irsad-najib/capstone/3d-new/preview/adj_detail.png

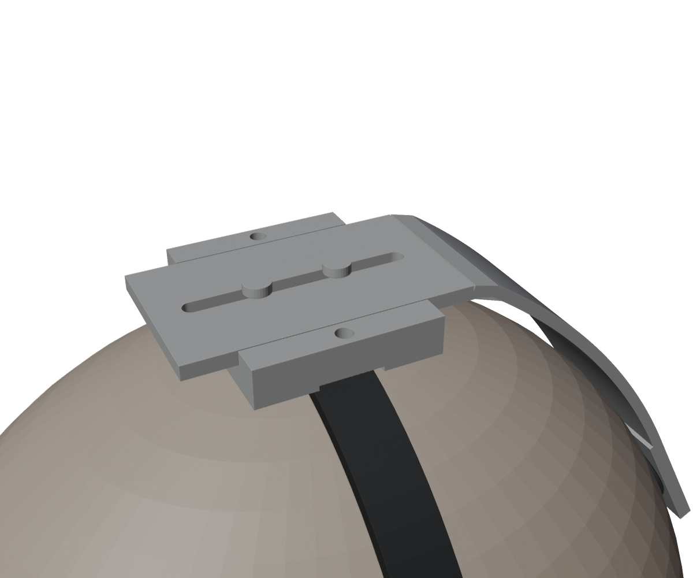
3d-new/preview/adj_detail.png
