irsad-najib/capstone/3d-new/preview/adj_persp.png

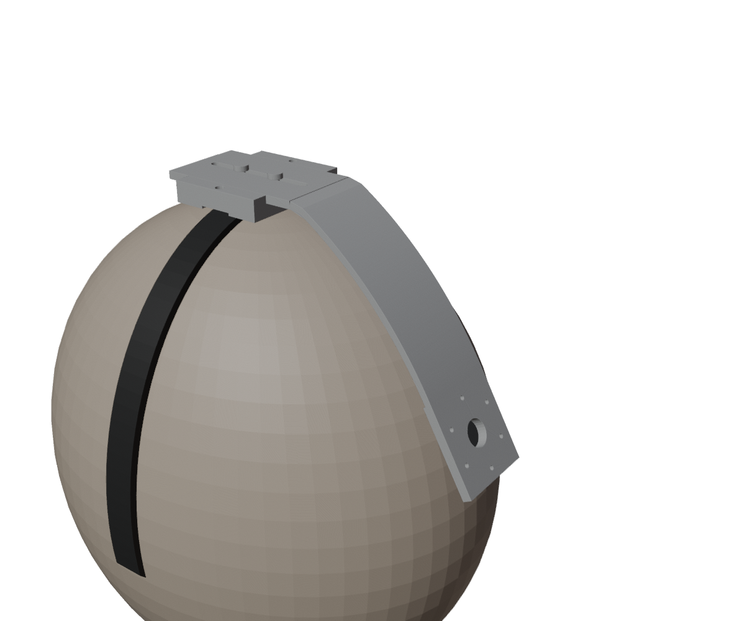
3d-new/preview/adj_persp.png
