irsad-najib/capstone/3d-new/preview/adj_side.png

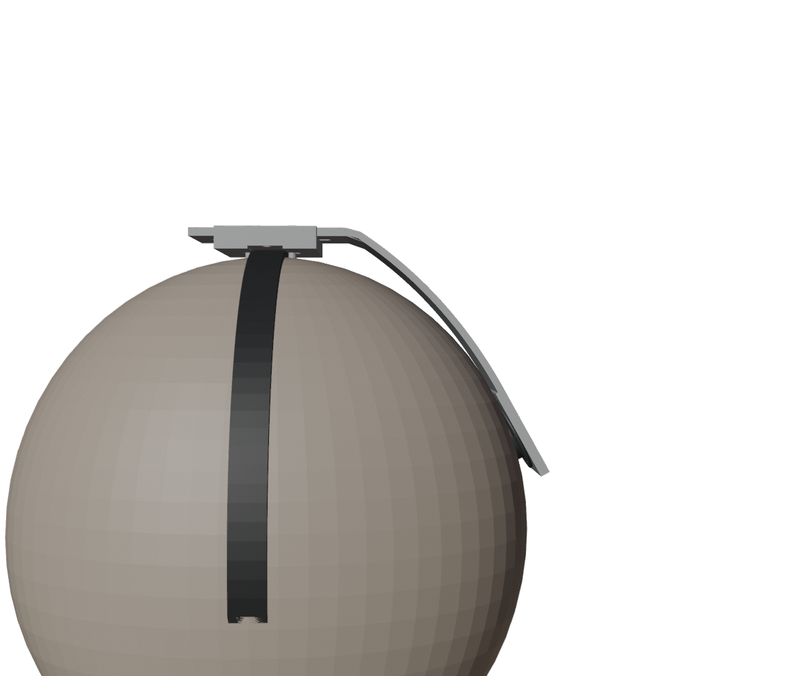
3d-new/preview/adj_side.png
