irsad-najib/capstone/3d-new/preview/arm_persp.png

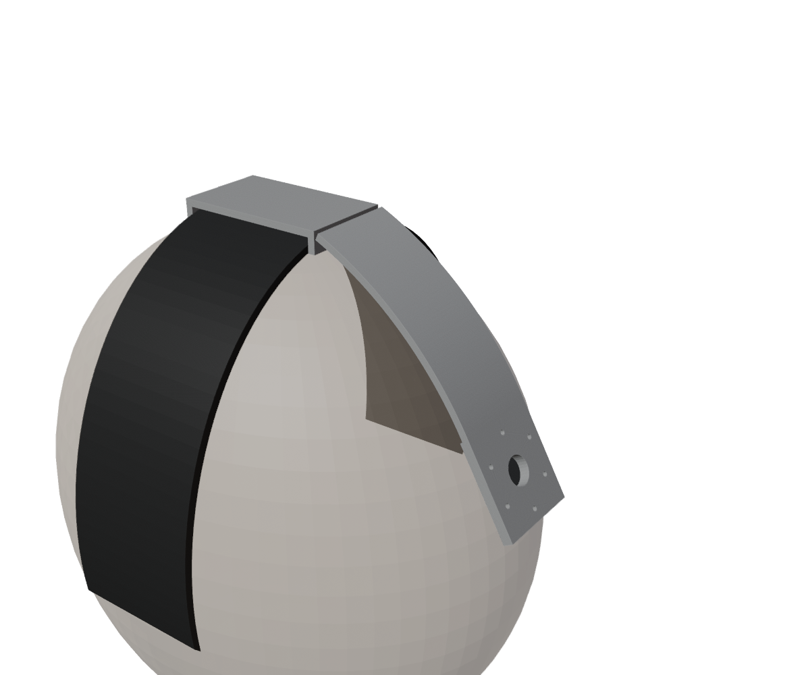
3d-new/preview/arm_persp.png
