irsad-najib/capstone/3d-new/preview/arm_side.png

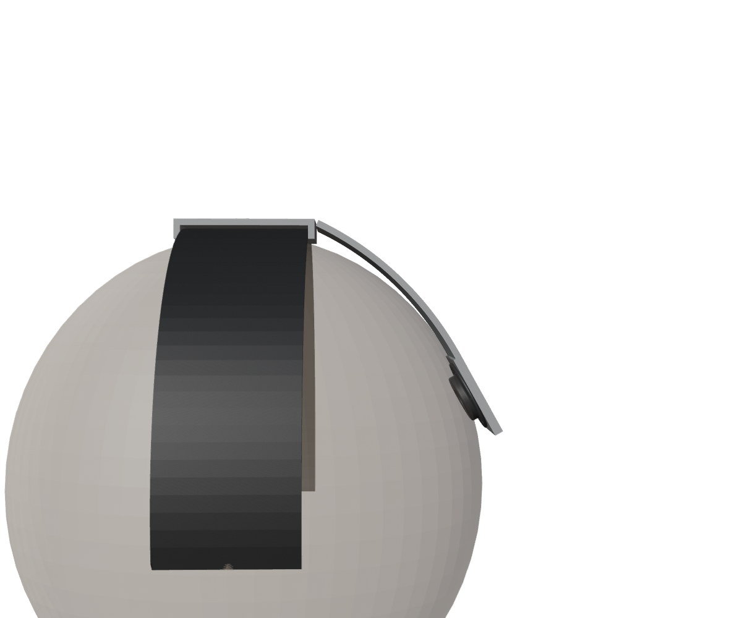
3d-new/preview/arm_side.png
