irsad-najib/capstone/capstone-3d/docs/preview_front_textured.png

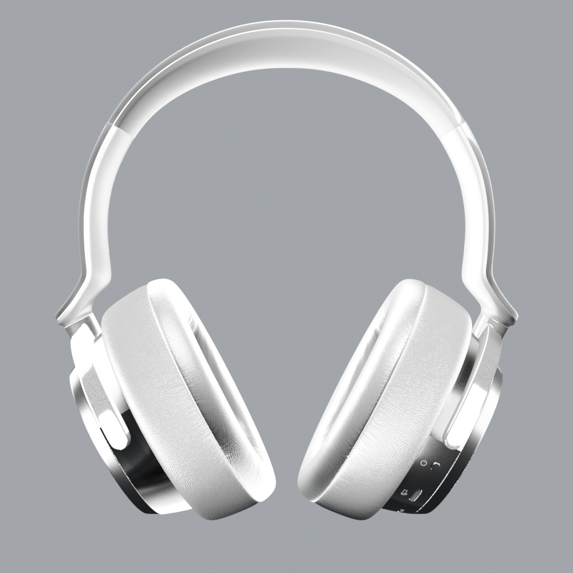
capstone-3d/docs/preview_front_textured.png
