irsad-najib/capstone/capstone-3d/docs/preview_hero.png

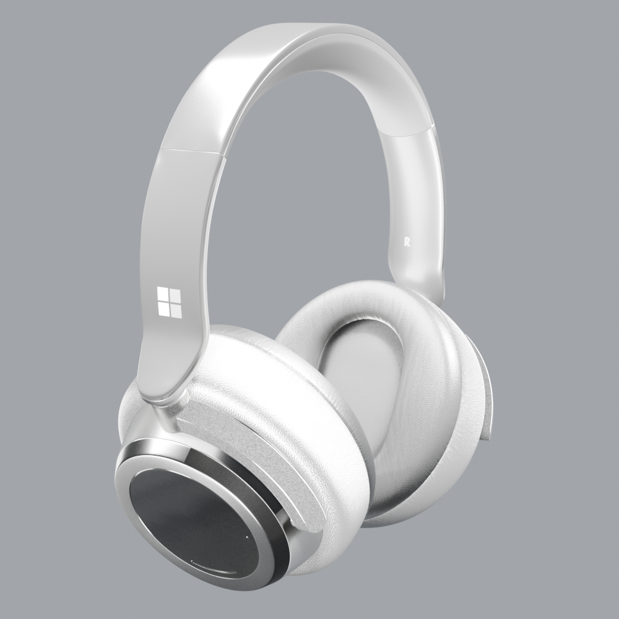
capstone-3d/docs/preview_hero.png
