irsad-najib/capstone/capstone-3d/docs/redesign_front.png

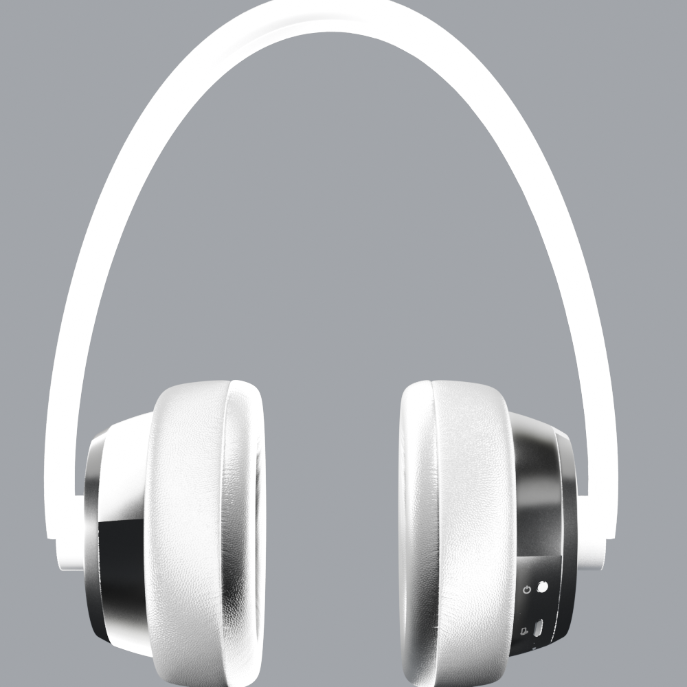
capstone-3d/docs/redesign_front.png
