irsad-najib/capstone/capstone-3d/docs/redesign_hero.png

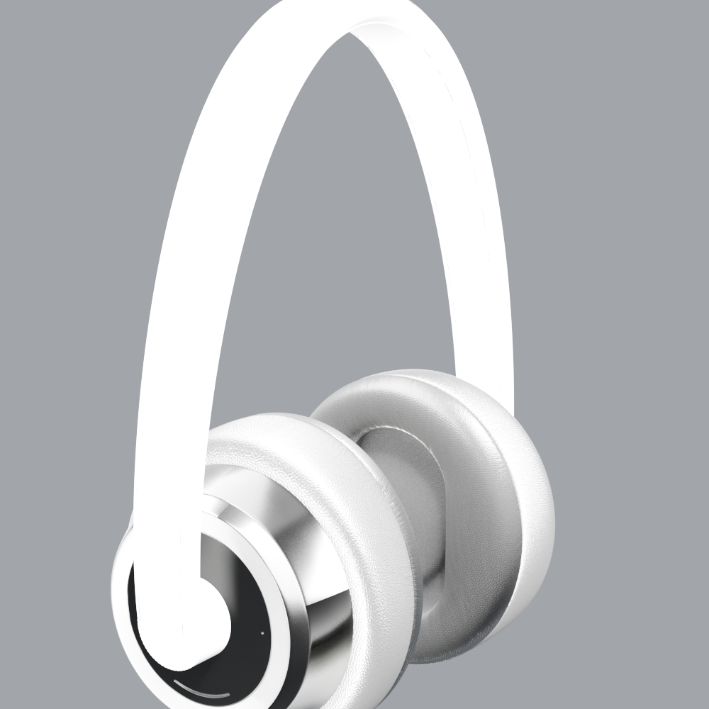
capstone-3d/docs/redesign_hero.png
