irsad-najib/capstone/capstone-3d/docs/v2_front.png

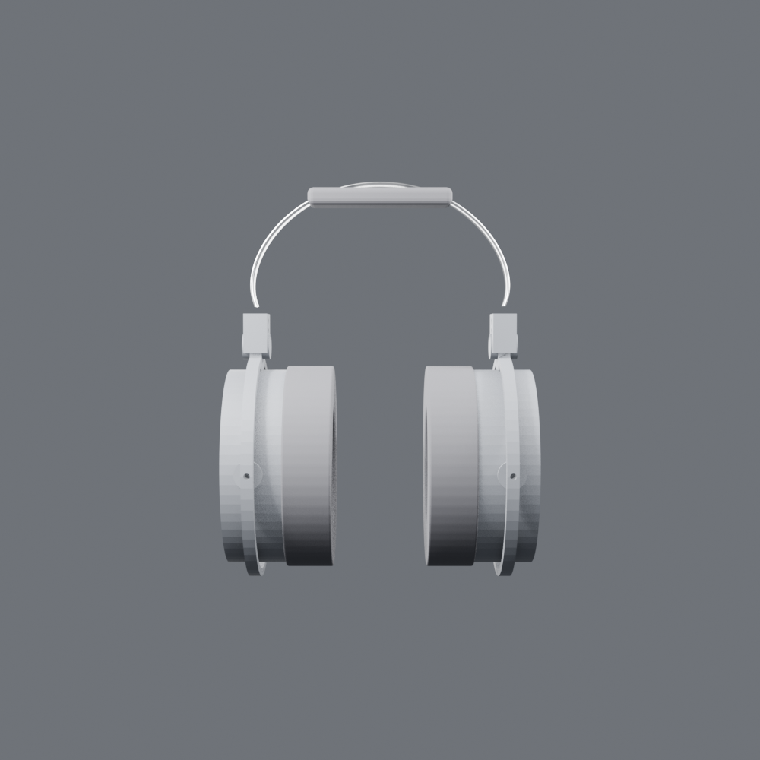
capstone-3d/docs/v2_front.png
