irsad-najib/capstone/capstone-3d/docs/v2_hero.png

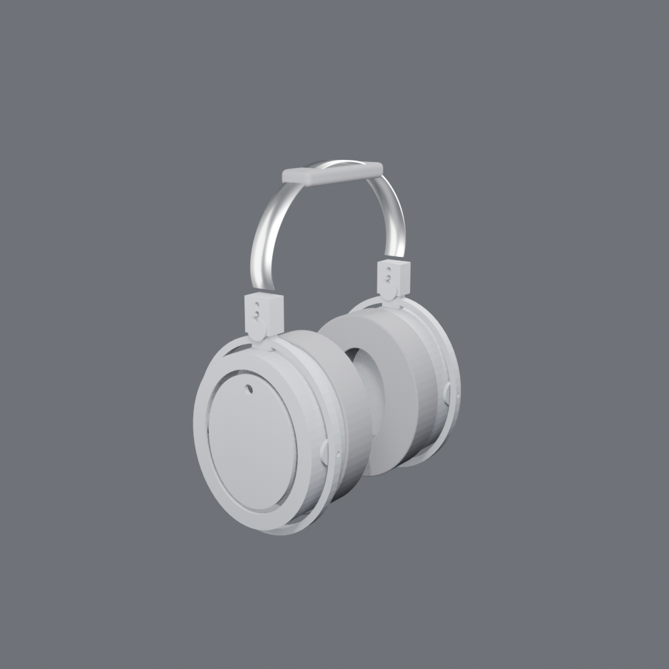
capstone-3d/docs/v2_hero.png
