irsad-najib/capstone/capstone-3d/docs/v2_side.png

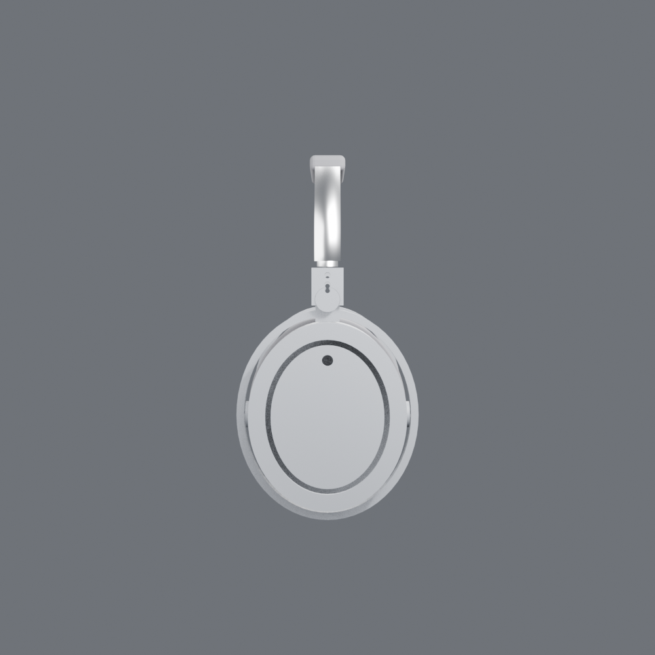
capstone-3d/docs/v2_side.png
