irsad-najib/capstone/frontend/stitch_neuropulse_abr_screening_system/neurosound_live_scan_mobile/screen.png

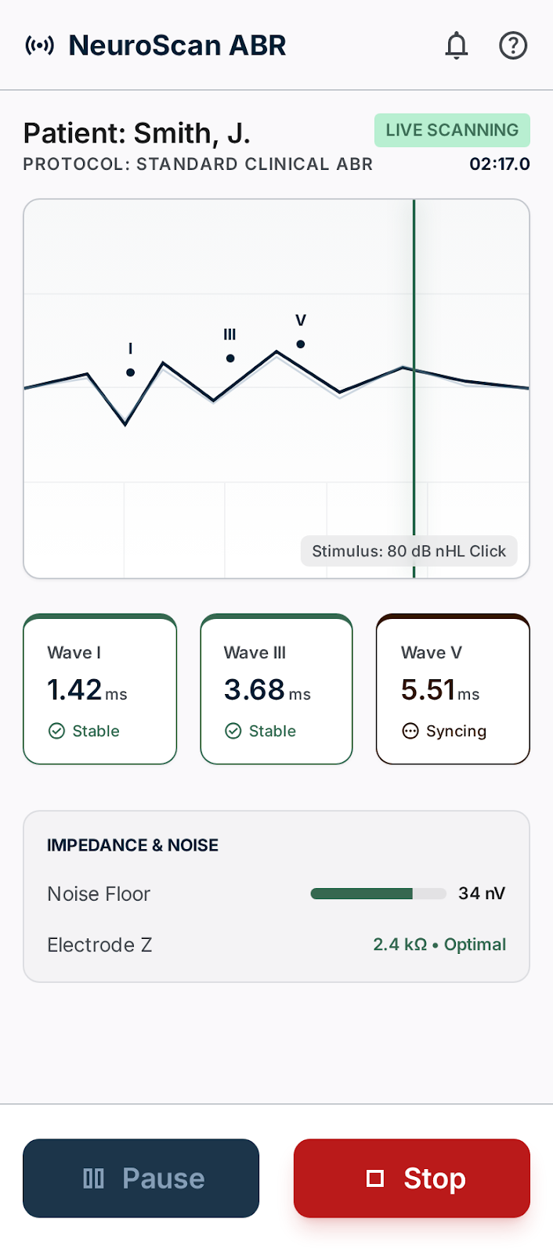
frontend/stitch_neuropulse_abr_screening_system/neurosound_live_scan_mobile/screen.png
