irsad-najib/capstone/3d-new/arsip/export_lama/Corong_Pelat_PETG.stl

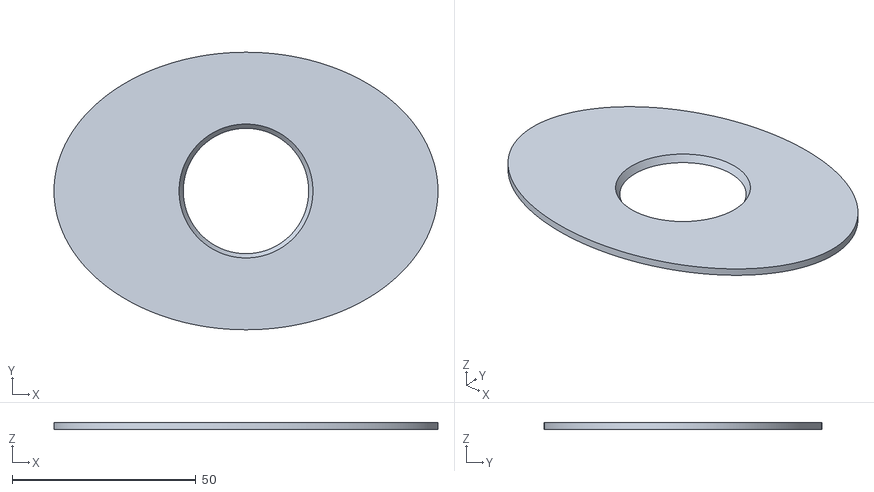
[picture p19: CAD file, 2026-10-26]
3d-new/arsip/export_lama/Corong_Pelat_PETG.stl
104.6 x 75.6 x 2.00
