irsad-najib/capstone/3d-new/BAMBU PROJECT/Dudukan_Driver.3mf

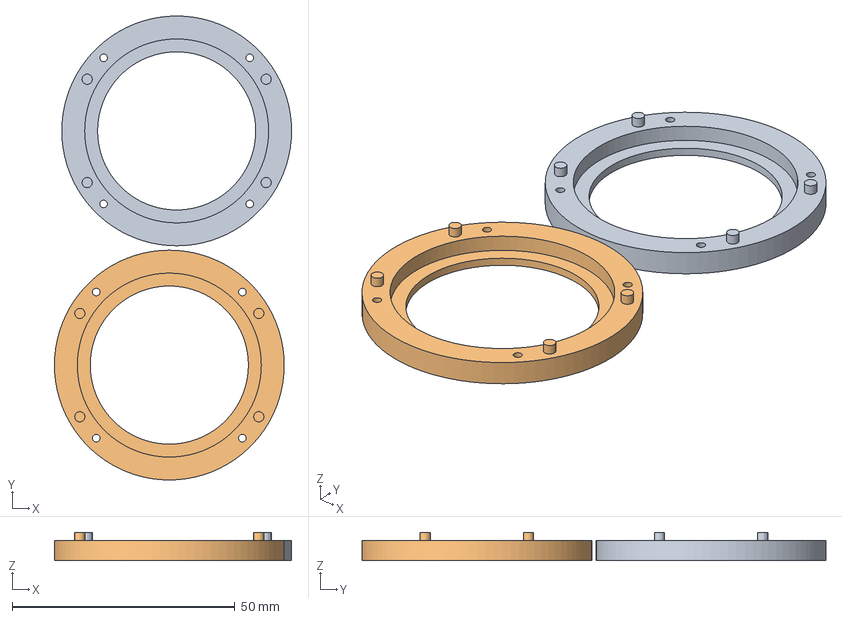
[picture p20: CAD file, 2026-10-26]
3d-new/BAMBU PROJECT/Dudukan_Driver.3mf
53.3 x 104.2 x 6.30 mm
Dudukan_Driver.stl x 2
