irsad-najib/capstone/3d-new/export/Corong_TPU.stl

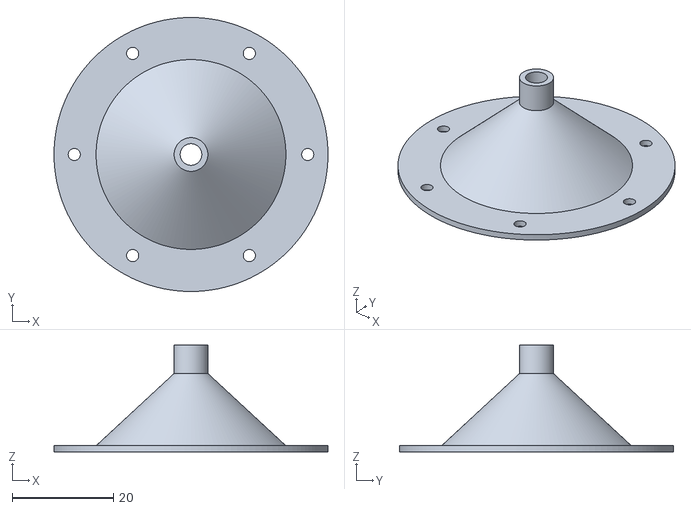
[picture p21: CAD file, 2026-10-26]
3d-new/export/Corong_TPU.stl
54.0 x 54.0 x 21.0
