irsad-najib/capstone/3d-new/export/uji_toleransi/Uji_Dudukan.stl

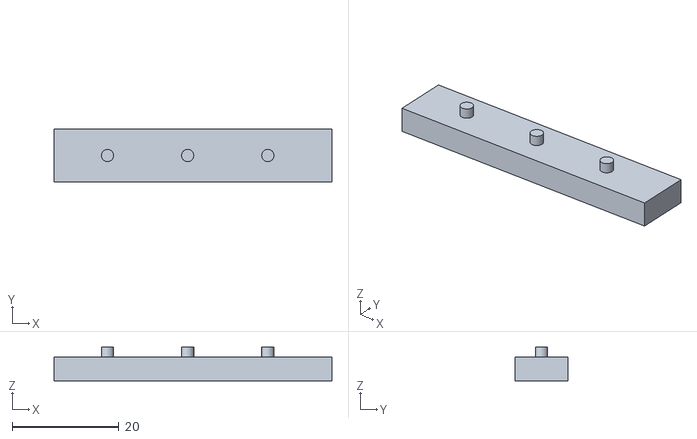
[picture p22: CAD file, 2026-10-26]
3d-new/export/uji_toleransi/Uji_Dudukan.stl
52.0 x 10.0 x 6.30
