irsad-najib/capstone/3d-new/arsip/export_lama/Kubah_Oval.stl

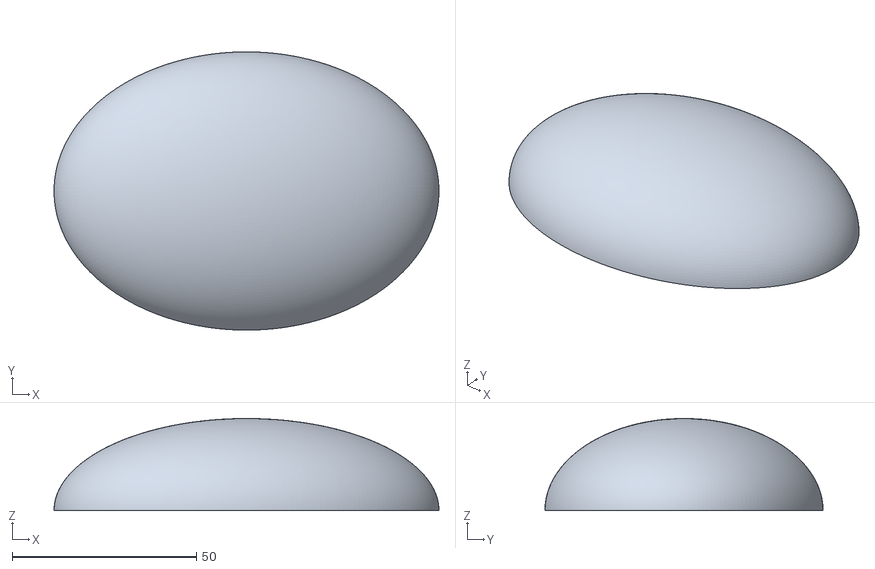
[picture p23: CAD file, 2026-10-26]
3d-new/arsip/export_lama/Kubah_Oval.stl
104.6 x 75.6 x 25.0
