irsad-najib/capstone/3d-new/BAMBU PROJECT/Uji_TPU.3mf

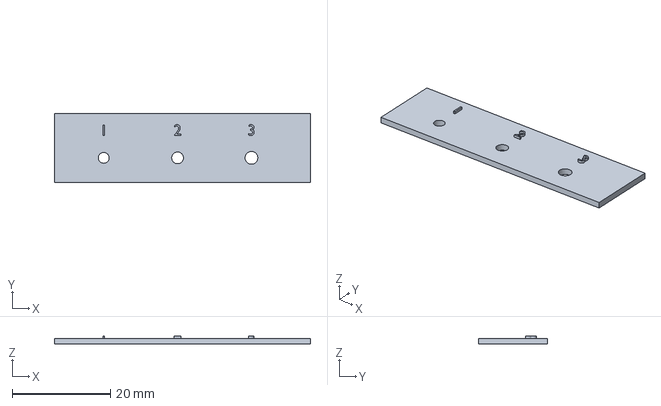
[picture p24: CAD file, 2026-10-26]
3d-new/BAMBU PROJECT/Uji_TPU.3mf
52.0 x 14.0 x 1.70 mm
