irsad-najib/capstone/3d-new/export/Kubah.stl

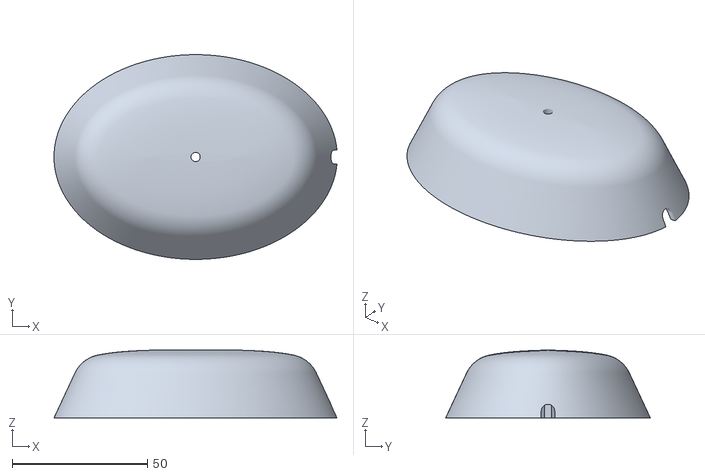
[picture p25: CAD file, 2026-10-26]
3d-new/export/Kubah.stl
104.5 x 75.6 x 25.0
