irsad-najib/capstone/3d-new/arsip/export_lama/Corong_Kerucut_TPU.stl

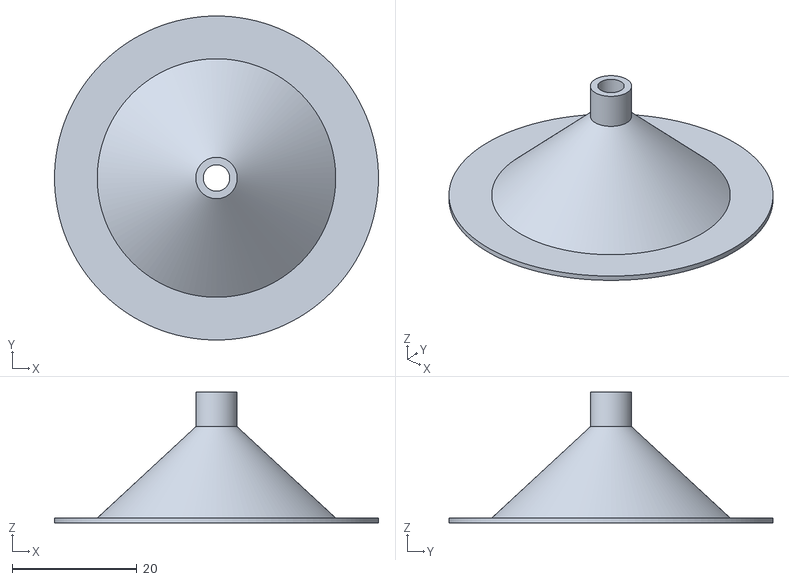
[picture p26: CAD file, 2026-10-26]
3d-new/arsip/export_lama/Corong_Kerucut_TPU.stl
52.0 x 52.0 x 21.0
