irsad-najib/capstone/3d-new/BAMBU PROJECT/corong.3mf

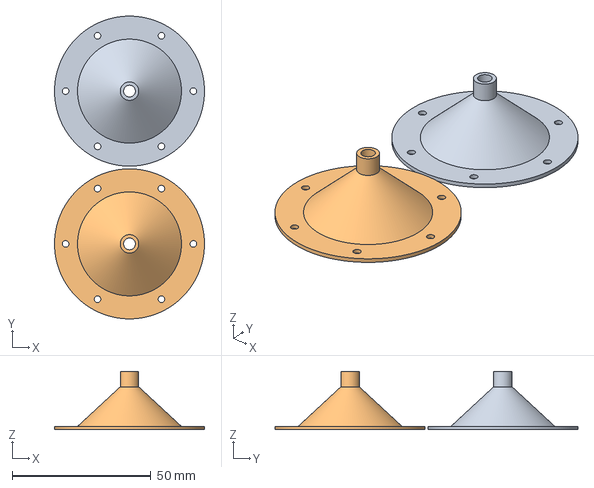
[picture p27: CAD file, 2026-10-26]
3d-new/BAMBU PROJECT/corong.3mf
54.0 x 109.0 x 21.0 mm
Corong_TPU.stl x 2
