irsad-najib/capstone/3d-new/export/Pelat_PETG.stl

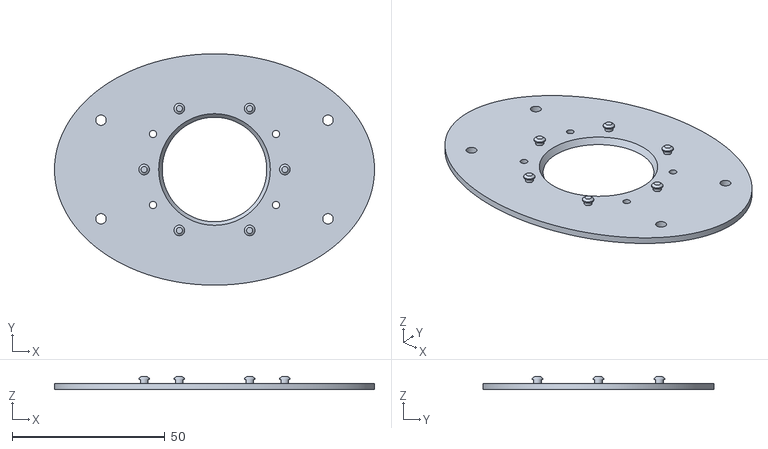
[picture p28: CAD file, 2026-10-26]
3d-new/export/Pelat_PETG.stl
104.6 x 75.6 x 4.20
