irsad-najib/capstone/3d-new/export/uji_toleransi/Uji_Tiang.stl

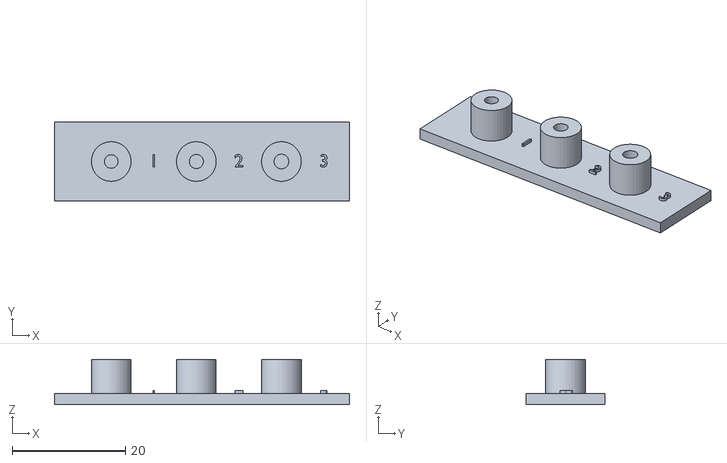
[picture p29: CAD file, 2026-10-26]
3d-new/export/uji_toleransi/Uji_Tiang.stl
52.0 x 14.0 x 8.00
