irsad-najib/capstone/3d-new/BAMBU PROJECT/Pelat_PETG.3mf

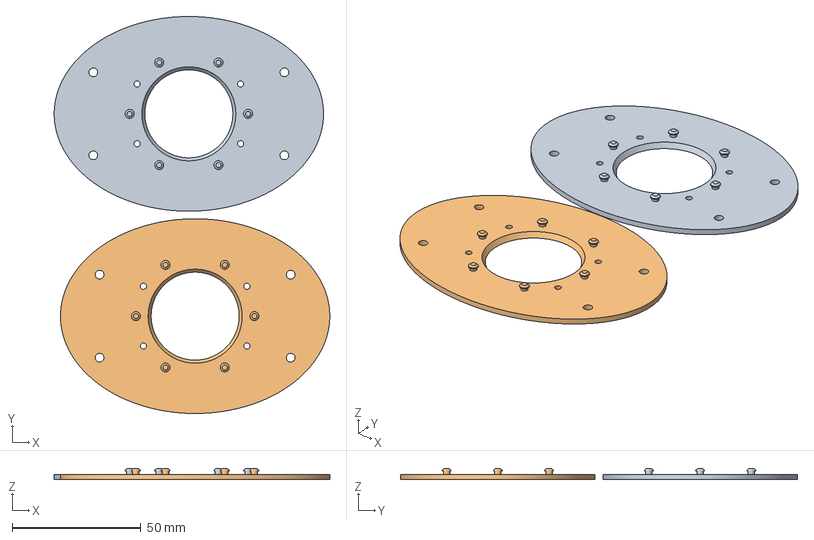
[picture p30: CAD file, 2026-10-26]
3d-new/BAMBU PROJECT/Pelat_PETG.3mf
107.0 x 154.2 x 4.20 mm
Pelat_PETG.stl x 2
