irsad-najib/capstone/3d-new/export/Dudukan_Driver.stl

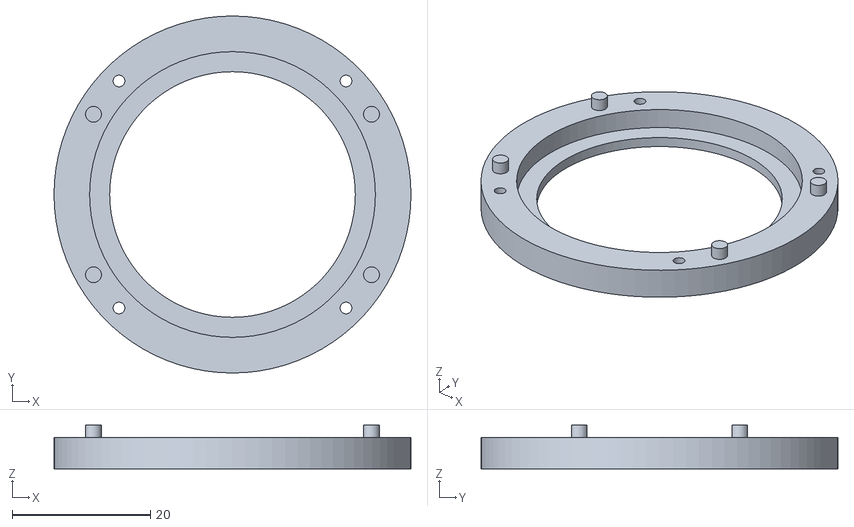
[picture p31: CAD file, 2026-10-26]
3d-new/export/Dudukan_Driver.stl
51.6 x 51.6 x 6.30
