irsad-najib/capstone/3d-new/export/uji_toleransi/Uji_Pelat.stl

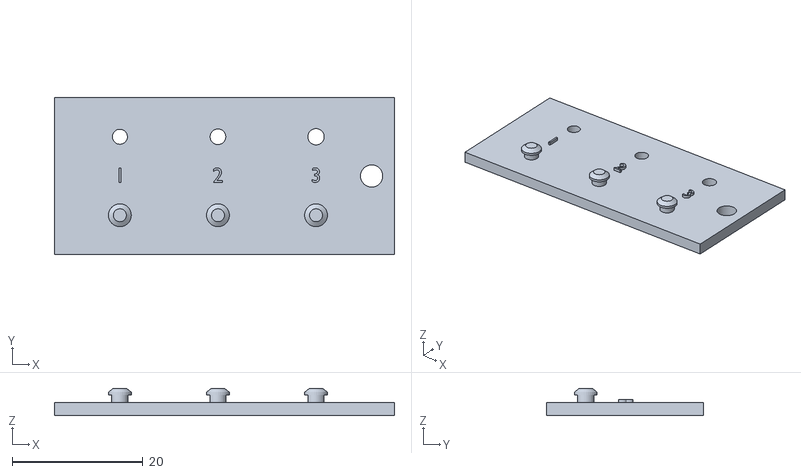
[picture p32: CAD file, 2026-10-26]
3d-new/export/uji_toleransi/Uji_Pelat.stl
52.0 x 24.0 x 4.20
