irsad-najib/capstone/3d-new/BAMBU PROJECT/Uji_PETG.3mf

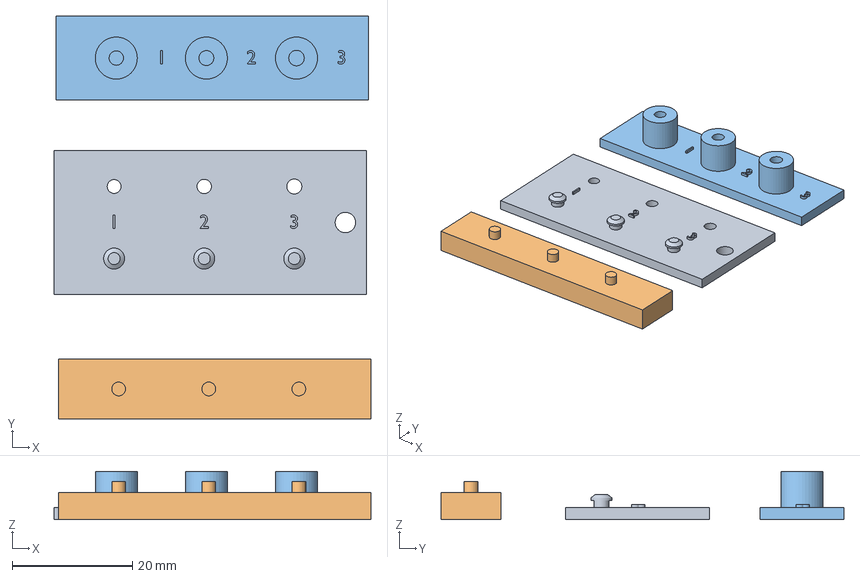
[picture p33: CAD file, 2026-10-26]
3d-new/BAMBU PROJECT/Uji_PETG.3mf
52.8 x 67.1 x 8.00 mm
Uji_Pelat.stl
Uji_Dudukan.stl
Uji_Tiang.stl
