irsad-najib/capstone/3d-new/BAMBU PROJECT/Kubah.3mf

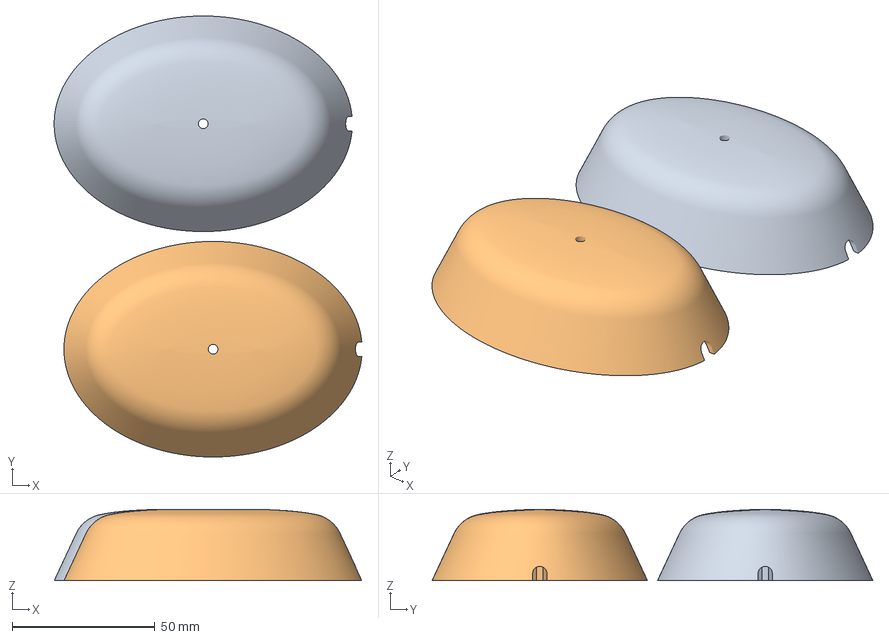
[picture p34: CAD file, 2026-10-26]
3d-new/BAMBU PROJECT/Kubah.3mf
107.9 x 154.7 x 25.0 mm
Kubah.stl x 2
