irsad-najib/capstone/(list of files, cad)

Other CAD files:
3d-new/export/uji_toleransi/Uji_TPU.stl
