irsad-najib/capstone/frontend/stitch_neuropulse_abr_screening_system/neurosound_scan_results_desktop/code.html

neurology

Neurosound Clinical Portal

Clinician Profile

Dr. Sarah Miller Neurologist

menu

search

fingerprint Patient ID: 882-941

notifications account_circle

Diagnostic Result

# NORMAL

Response detected bilaterally. ABR waveforms demonstrate clear morphology and latencies within expected clinical ranges for age and gender.

picture_as_pdf Export Report

Visual Analysis Detailed Metrics

### ABR Waveforms

Left Ear (31.1/s)

Right Ear (31.1/s)

zoom_in fullscreen

#### Key Indicators

Wave V Latency

5.64 ms

Threshold

20 dB nHL

#### Clinical Notes

"Tympanometry Type A bilaterally. Infant remained in quiet sleep for the duration of the scan. Signal quality excellent with minimal artifact rejection."

Component | Latency (ms) | Amplitude (µV) | Status
Wave I | 1.62 | 0.24 | Normal
Wave III | 3.78 | 0.38 | Normal
Wave V | 5.64 | 0.52 | Normal

#### Scan Parameters

Stimulus

Click 100μs

Rate

31.1 / sec

Polarity

Rarefaction

Filter

100-3kHz

#### Signal Integrity

Sweep Completion 93.1%

2048 Sweeps, 142 Rejected. SNR 4.2:1 (Ideal)

© 2024 Neurosound Medical Systems. Clinical Diagnostic Support.

Support Compliance Logout
