irsad-najib/capstone/frontend/stitch_neuropulse_abr_screening_system/neurosound_scan_results_mobile/code.html

arrow_back Scan Results

notifications help_outline

Analysis Status

# NORMAL

check_circle Auditary Brainstem Response Stable

SUMMARY DETAILED METRICS

timer Latency

5.2 ms

signal_cellular_alt SNR

12.4 dB

### ABR Waveform Analysis

fullscreen

ABR Waveform

Wave I Wave V

Left Ear (320Hz)

Baseline

Stimulus Level 85 dB nHL

Click Polarity Rarefaction

Averages Count 2,048

#### Neural Synchrony

Wave V Latency 5.62 ms

Wave I-V Interval 3.98 ms

V/I Amplitude Ratio 2.41

#### Environmental Noise

EEG Residual Noise 24 nV

A-weighted Level 12 dB(A)

share EXPORT PDF save SAVE RECORD
