irsad-najib/capstone/frontend/stitch_neuropulse_abr_screening_system/neurosound_scan_history_desktop/code.html

# Neurosound

Clinical Portal

DR

Dr. Sarah Chen

Neuro-Audiologist

menu

## Neurosound

search

notifications account_circle

### History

Manage and review all patient scan data.

download Export

search

842 Normal

312 Abnormal

130 Inconclusive

Patient | Date | Result | Actions
Elena Rodriguez ID: 442-12 | Oct 24, 2024 | Normal | View
Marcus Thorne ID: 291-55 | Oct 23, 2024 | Abnormal | View
Sarah J. Miller ID: 112-88 | Oct 23, 2024 | Inconclusive | View
James Wilson ID: 673-42 | Oct 22, 2024 | Normal | View

Showing 4 of 1,284 results

chevron_left 1 2 3 chevron_right

© 2024 Neurosound Medical Systems. FDA Cleared.

Support Privacy Logout
