irsad-najib/capstone/frontend/stitch_neuropulse_abr_screening_system/neurosound_scan_history_mobile/code.html

NeuroScan ABR

notifications help_outline

# Scan History

search

All Scans Stable Review Needed Archived

person

### Liam Henderson

Stable

Oct 24, 2024 • ID: #4492-B

chevron_right

person

### Sarah Jenkins

Review Required

Oct 23, 2024 • ID: #4491-A

chevron_right

person

### Benjamin Thorne

Stable

Oct 23, 2024 • ID: #4489-C

chevron_right

Clinical Environment

#### Monthly Diagnostics Summary

You have completed 124 scans this month with 98% data accuracy.
