irsad-najib/capstone/frontend/stitch_neuropulse_abr_screening_system/neurosound_scan_history_desktop/screen.png

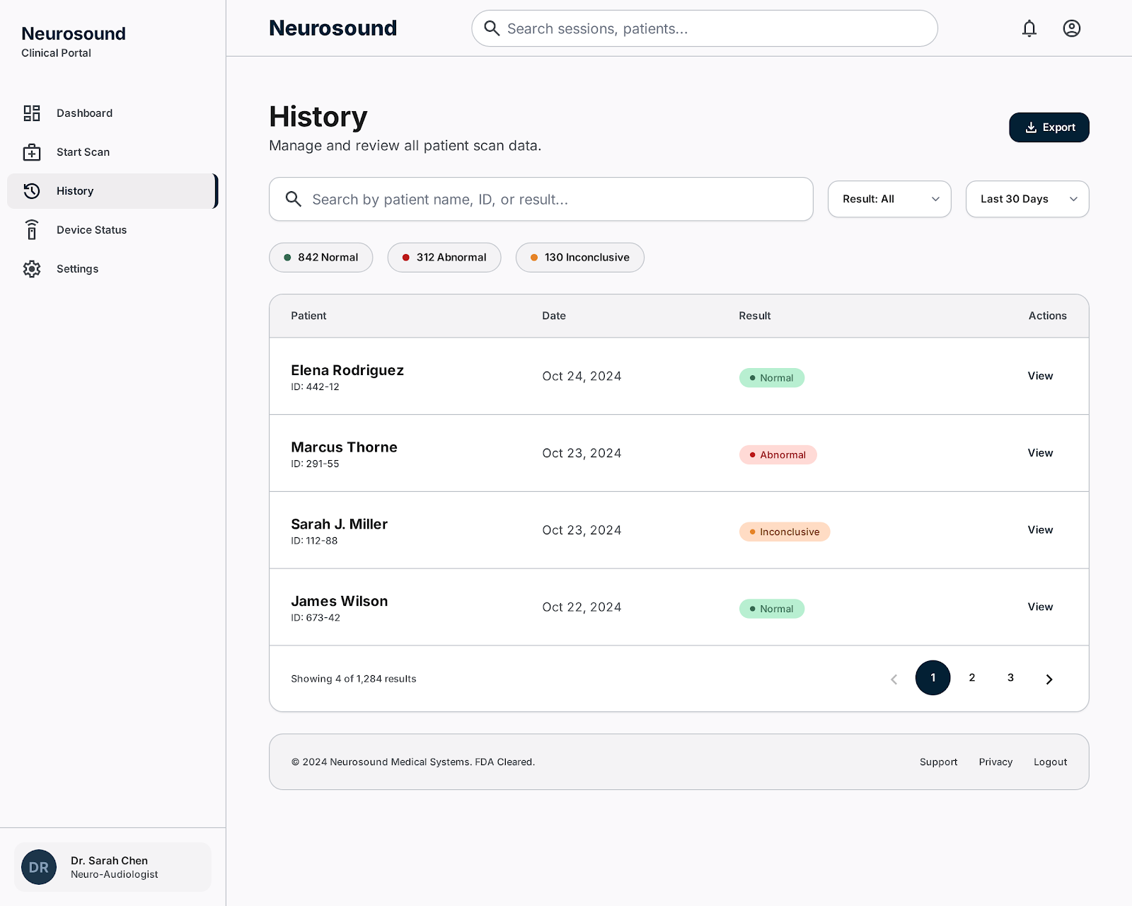
frontend/stitch_neuropulse_abr_screening_system/neurosound_scan_history_desktop/screen.png
