irsad-najib/capstone/schematic-fix/board-1-analog.pdf

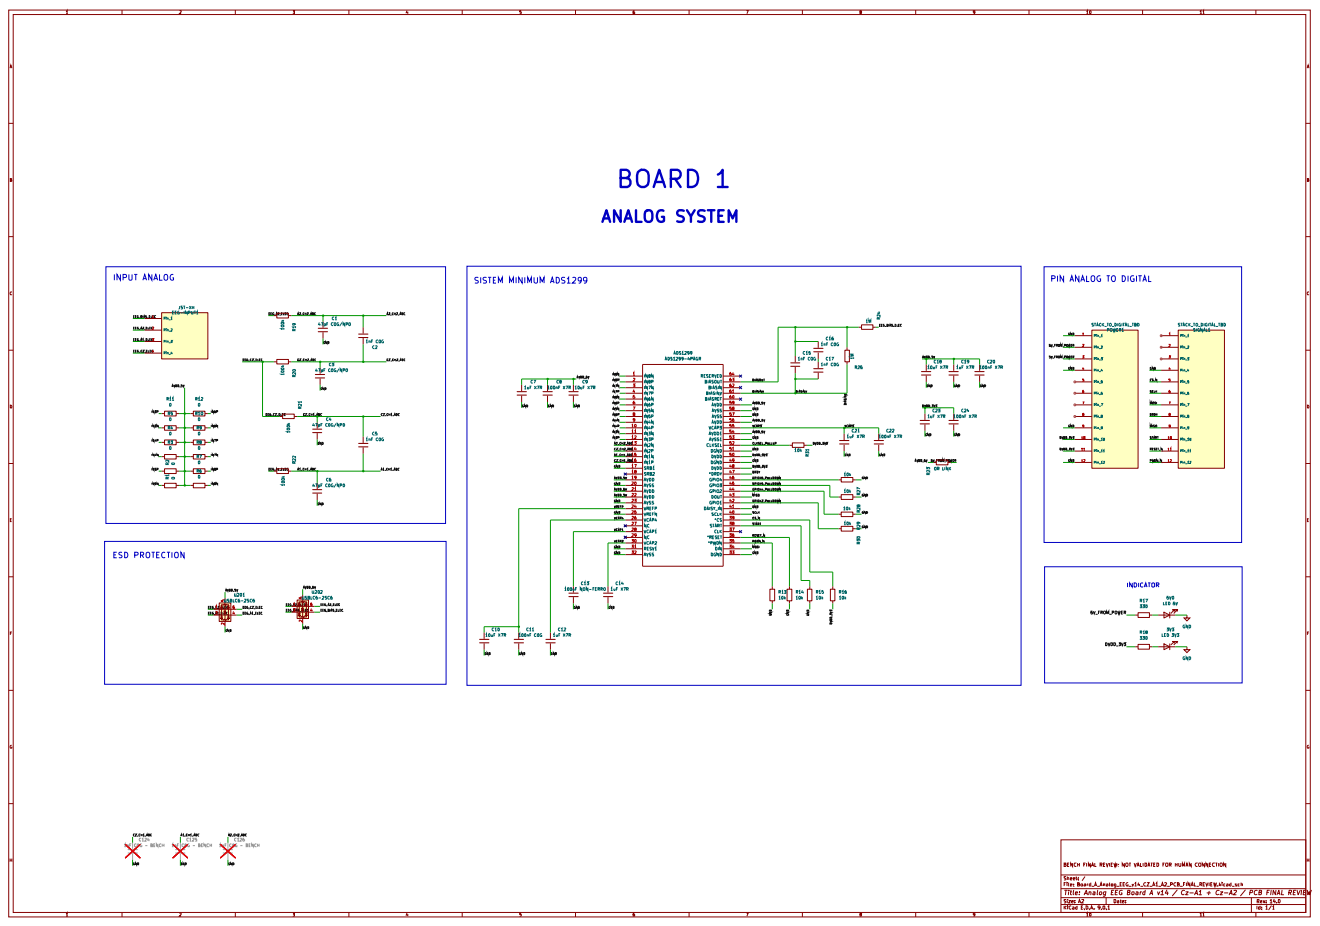
[picture p40: page 1]
