irsad-najib/capstone/schematic-fix/board-2-digital.pdf

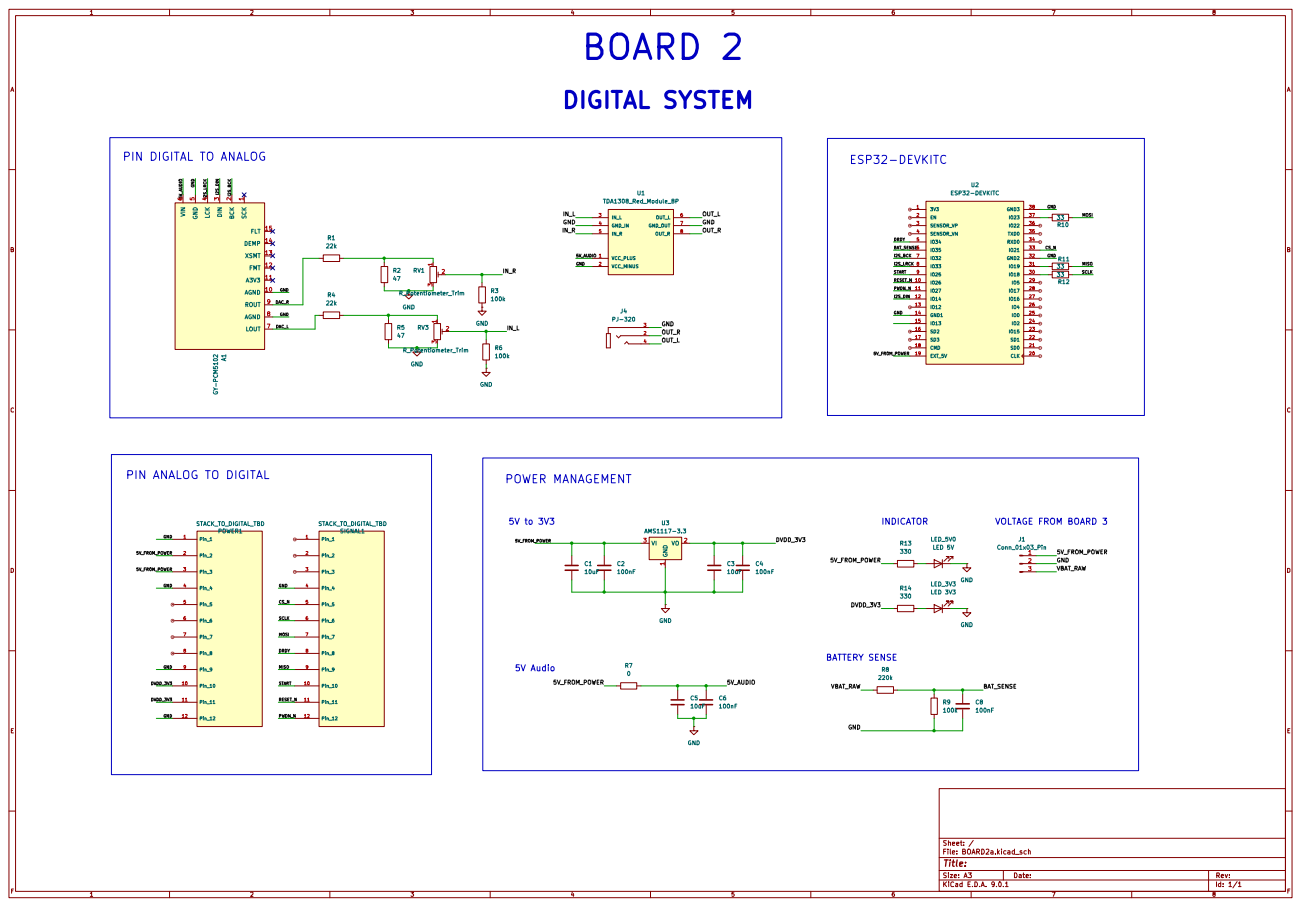
[picture p41: page 1]
