irsad-najib/capstone/archive/schematic/eeg_v1_pcb.pdf

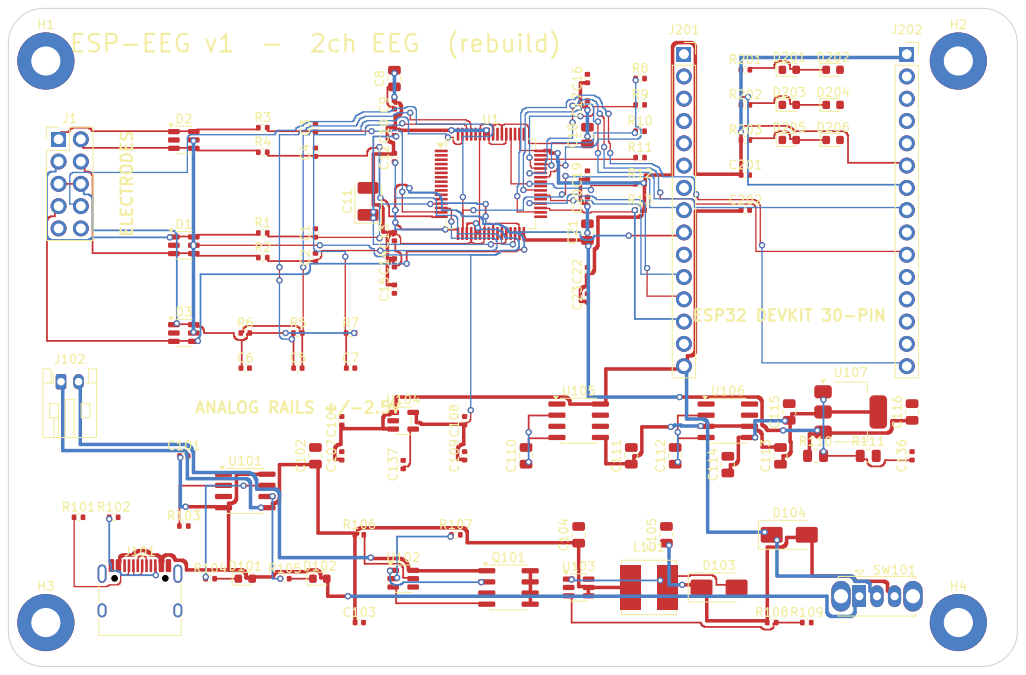
[picture p42: page 1]

ESP-EEG v1 - 2ch EEG (rebuild) ELECTRODES
