irsad-najib/capstone/archive/schematic/eeg_v1_schematic.pdf

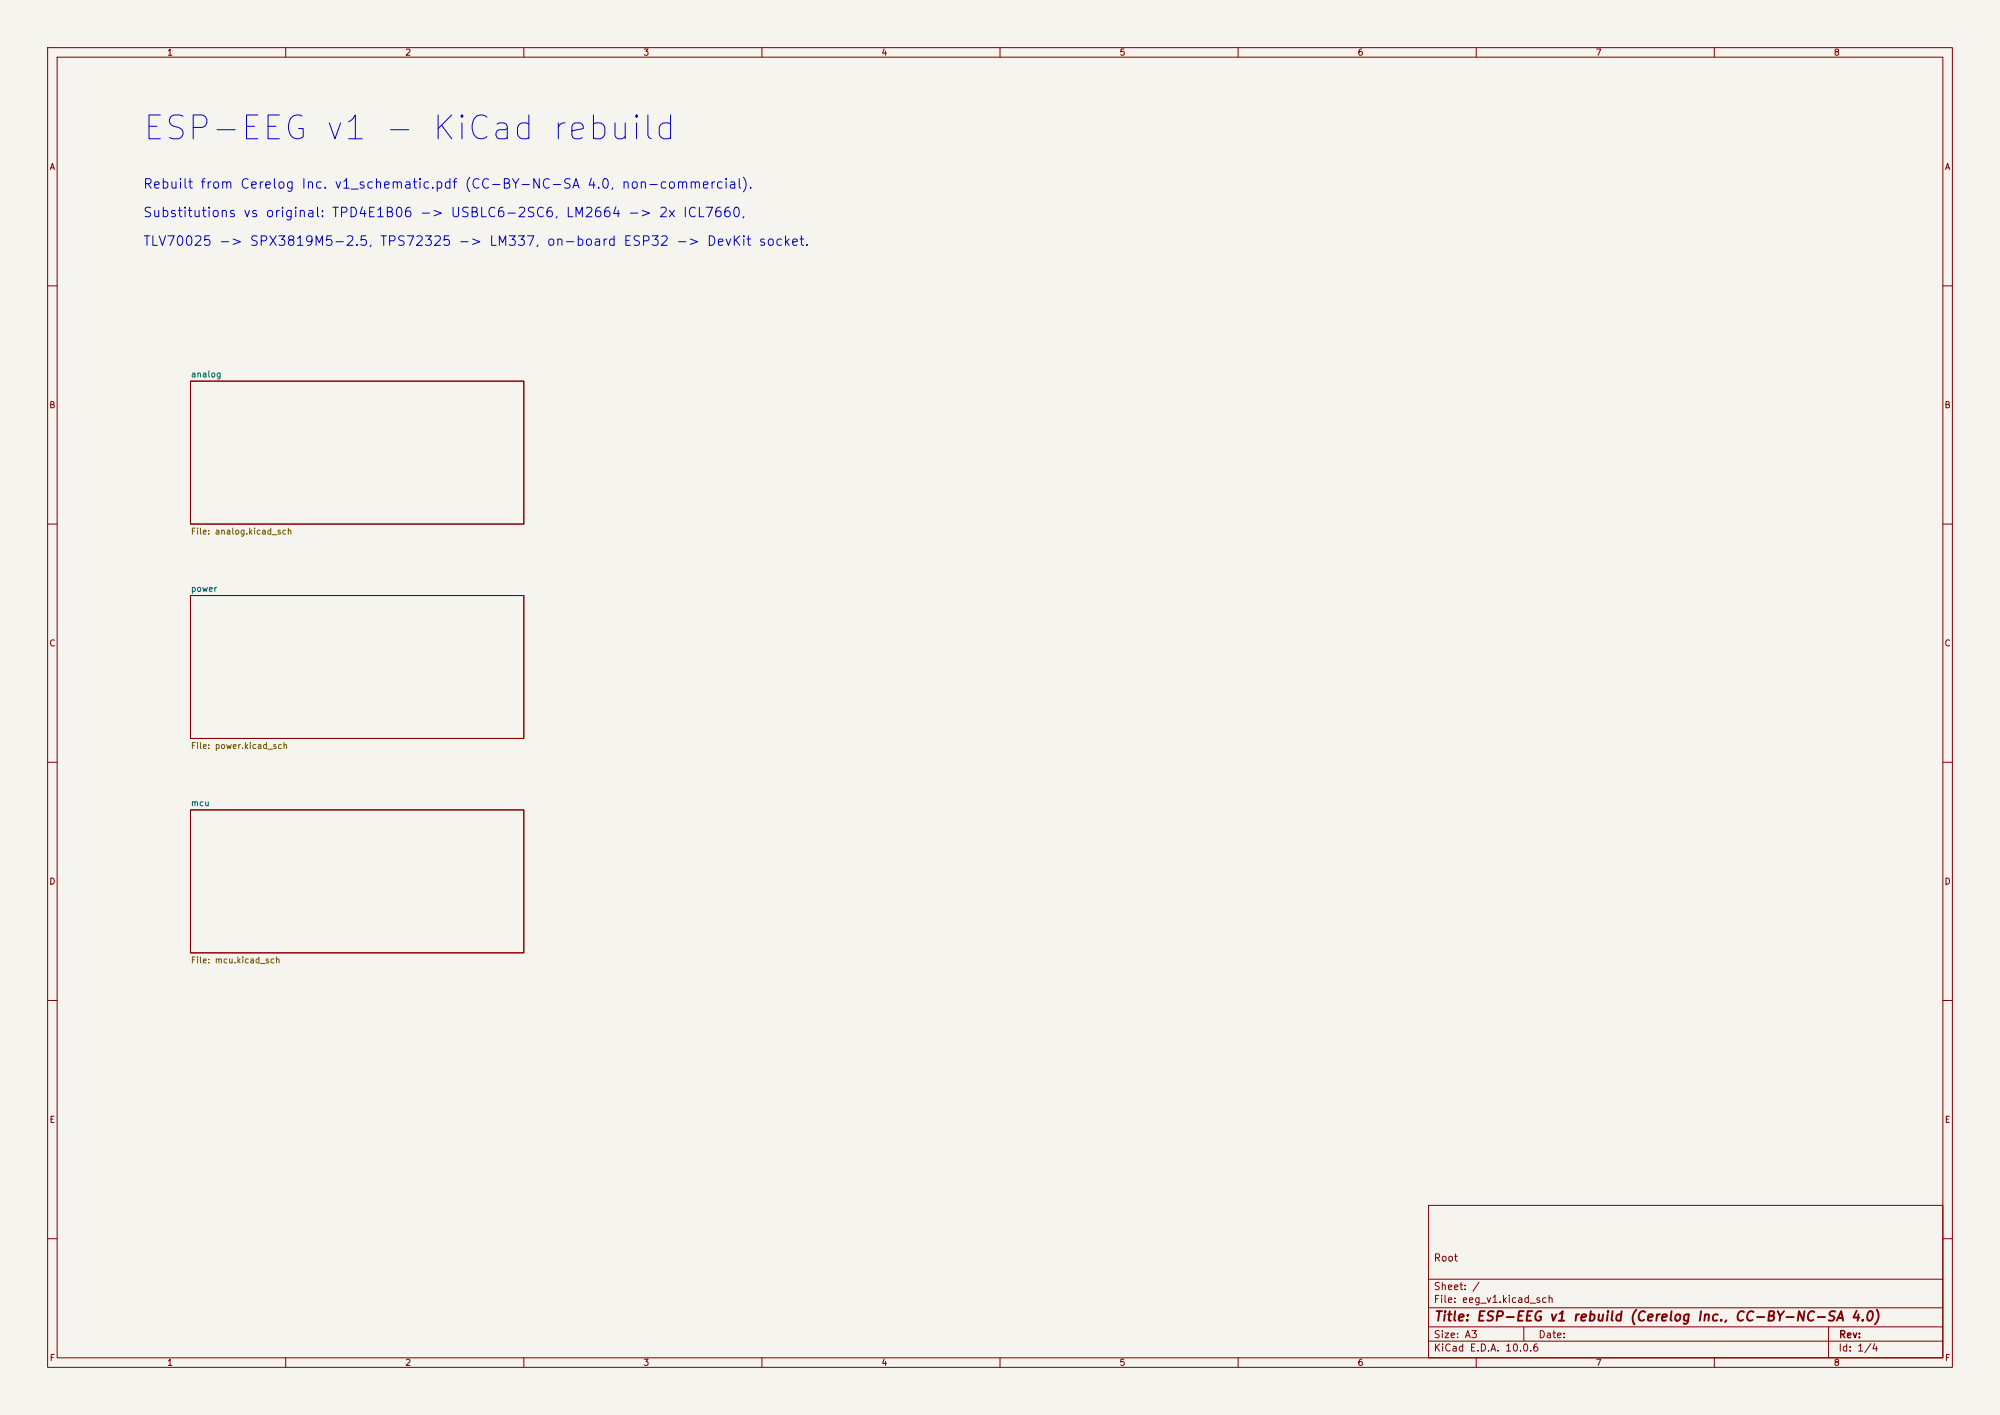
[picture p43: page 1]

File: mcu.kicad_sch ESP-EEG v1 - KiCad rebuild

Rebuilt from Cerelog Inc. v1_schematic.pdf (CC-BY-NC-SA 4.0, non-commercial).
Substitutions vs original: TPD4E1B06 -> USBLC6-2SC6, LM2664 -> 2x ICL7660,
TLV70025 -> SPX3819M5-2.5, TPS72325 -> LM337, on-board ESP32 -> DevKit socket.

File: analog.kicad_sch
power File: power.kicad_sch mcu

Sheet: /
File: eeg_v1.kicad_sch
Title: ESP-EEG v1 rebuild (Cerelog Inc., CC-BY-NC-SA 4.0)

Size: A3 | Rev: | F Date:
KiCad E.D.A. 10.0.6 | Id: 1/4

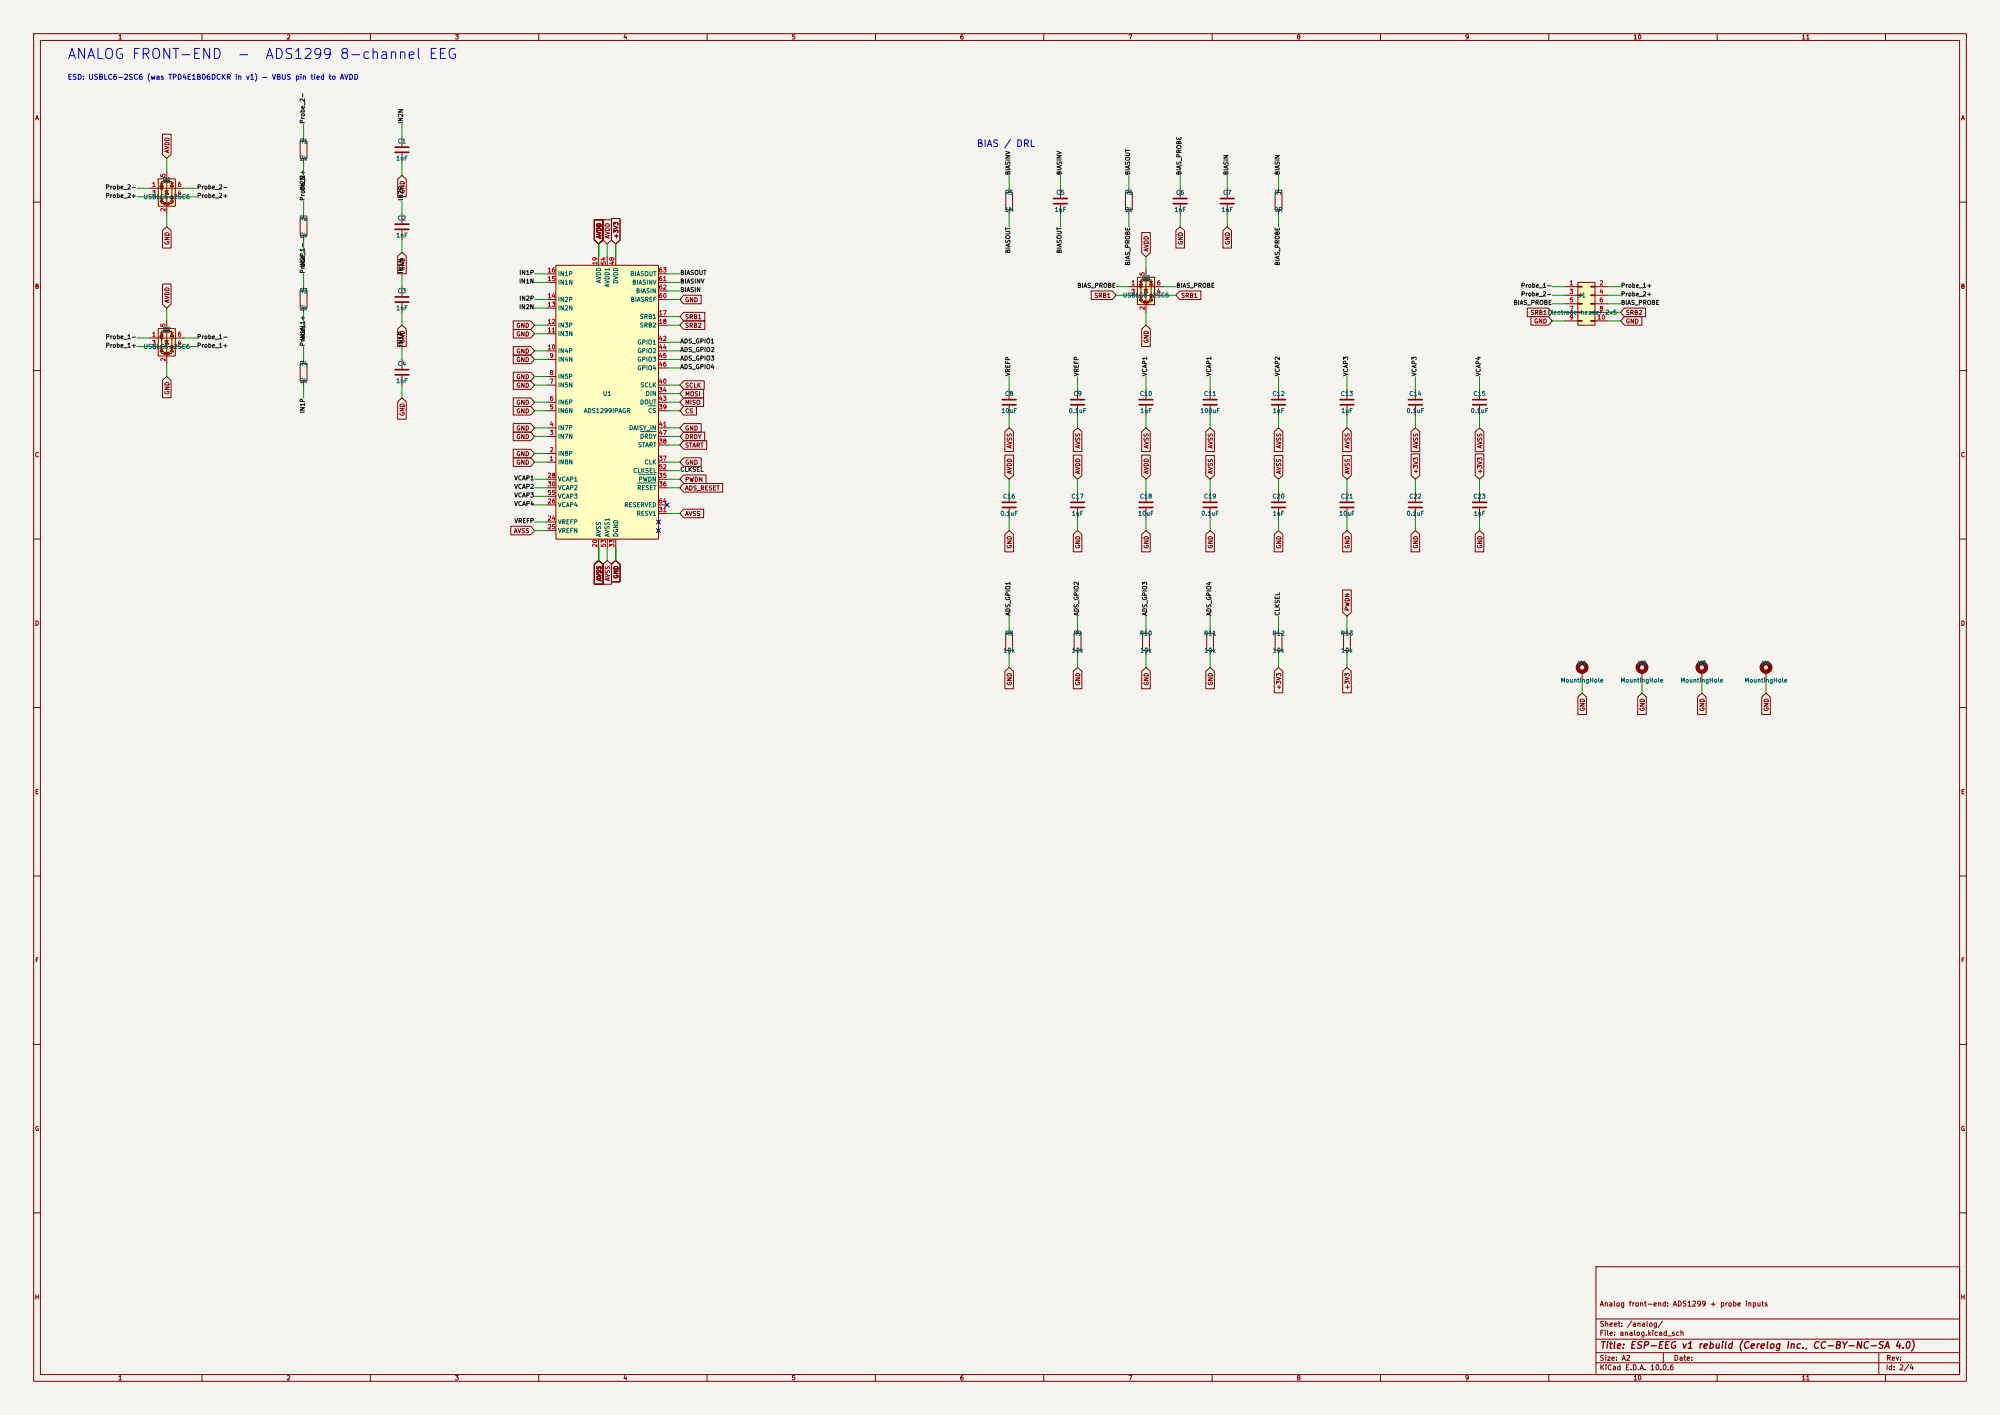
[picture p44: page 2]

ANALOG FRONT-END - ADS1299 8-channel EEG

ESD: USBLC6-2SC6 (was TPD4E1B06DCKR in v1) - VBUS pin tied to AVDD

Analog front-end: ADS1299 + probe inputs

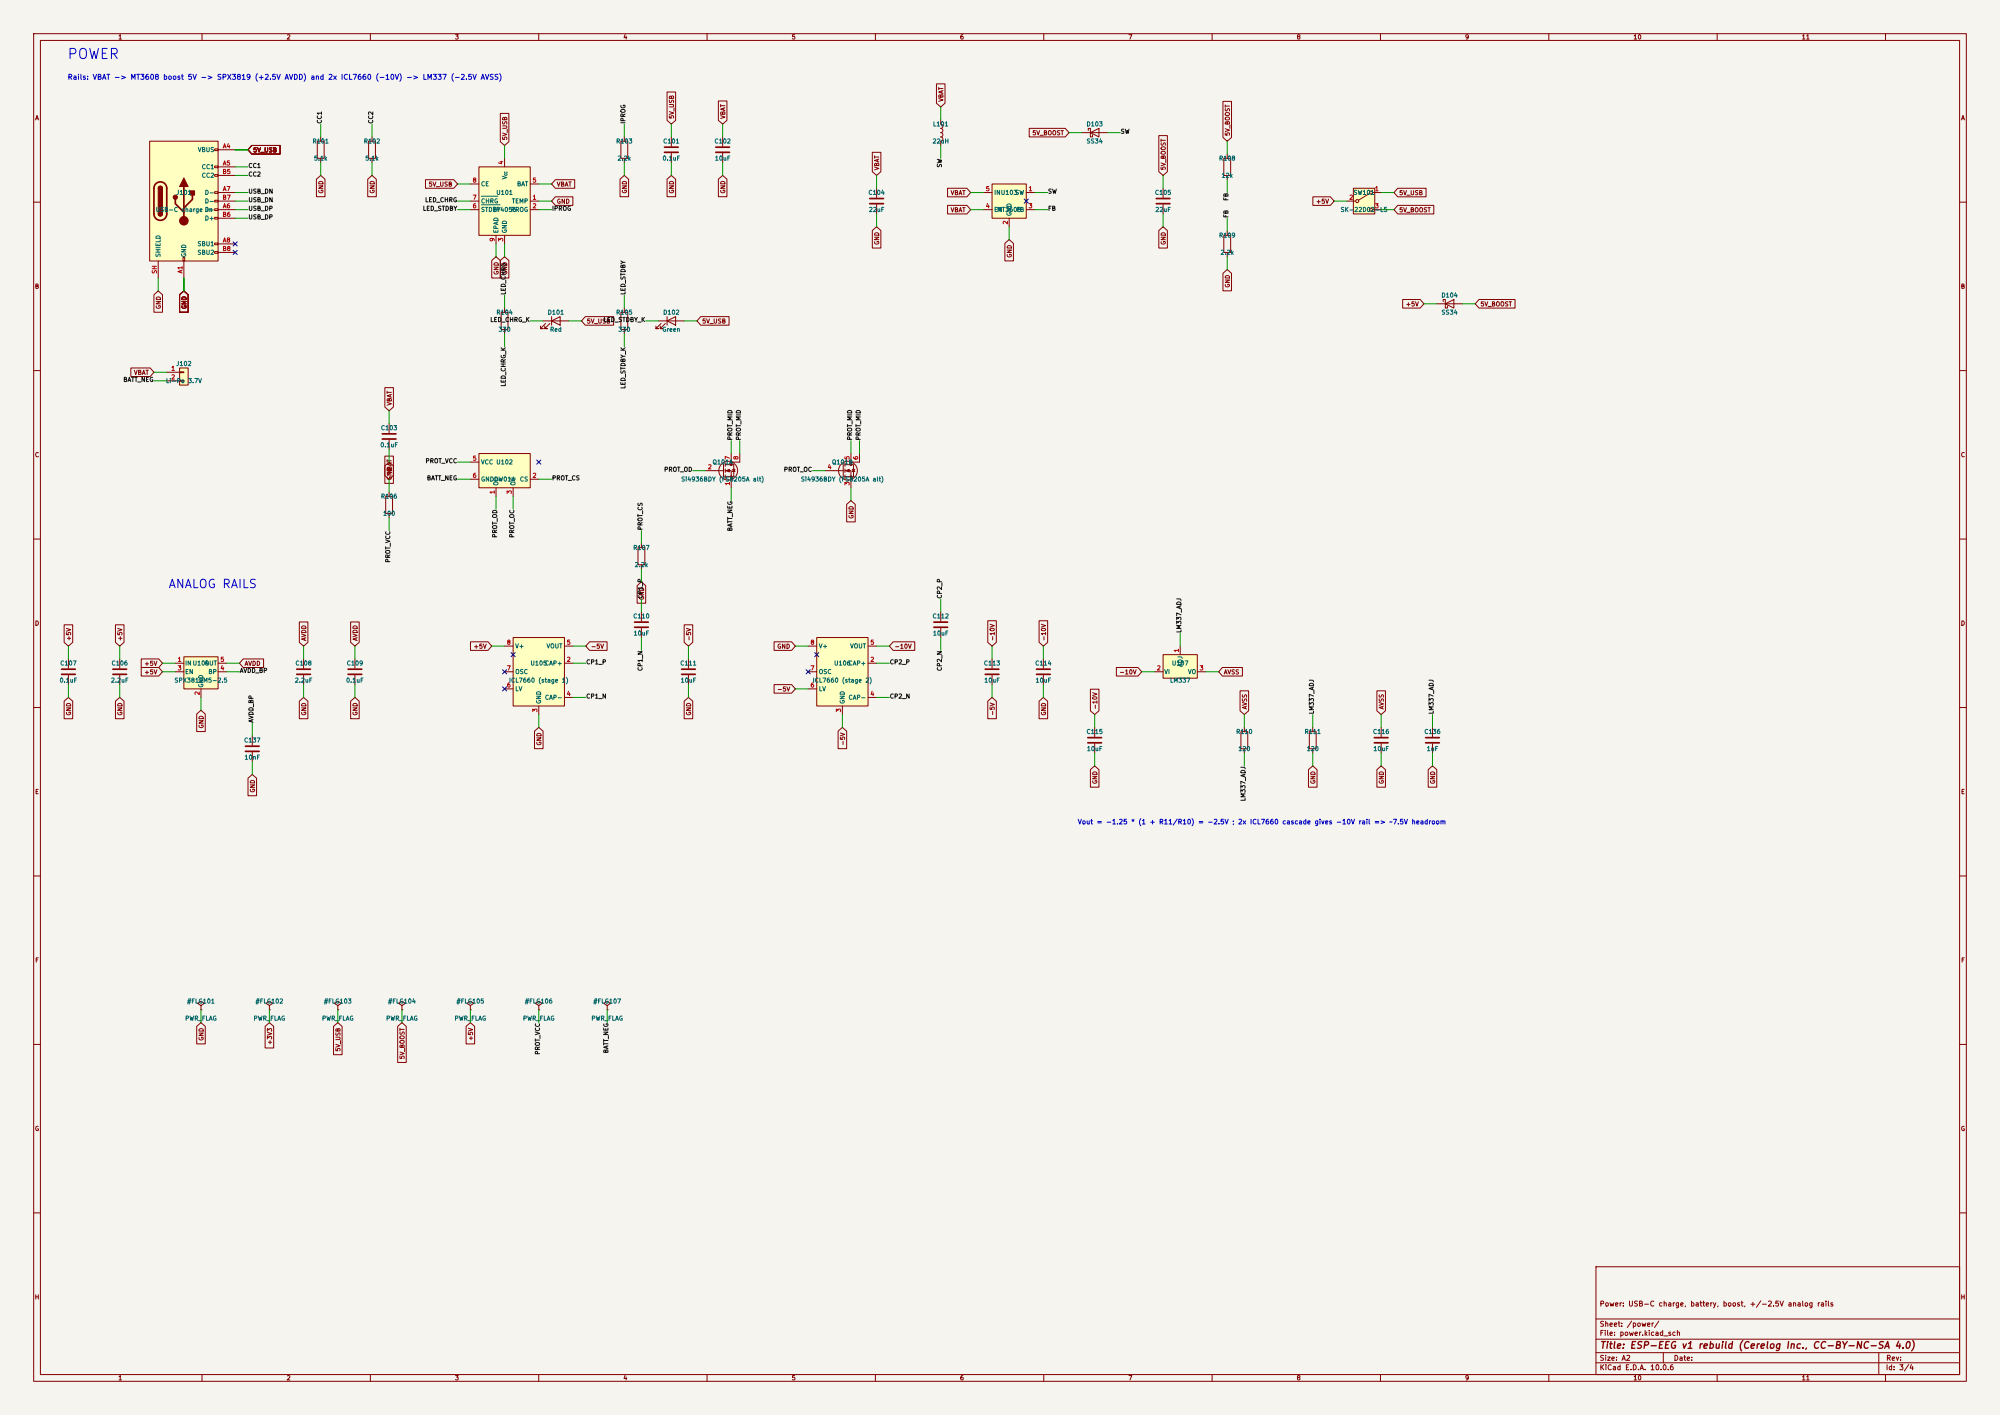
[picture p45: page 3]

Rails: VBAT -> MT3608 boost 5V -> SPX3819 (+2.5V AVDD) and 2x ICL7660 (-10V) -> LM337 (-2.5V AVSS)

Vout = -1.25 * (1 + R11/R10) = -2.5V ; 2x ICL7660 cascade gives -10V rail => ~7.5V headroom

Power: USB-C charge, battery, boost, +/-2.5V analog rails

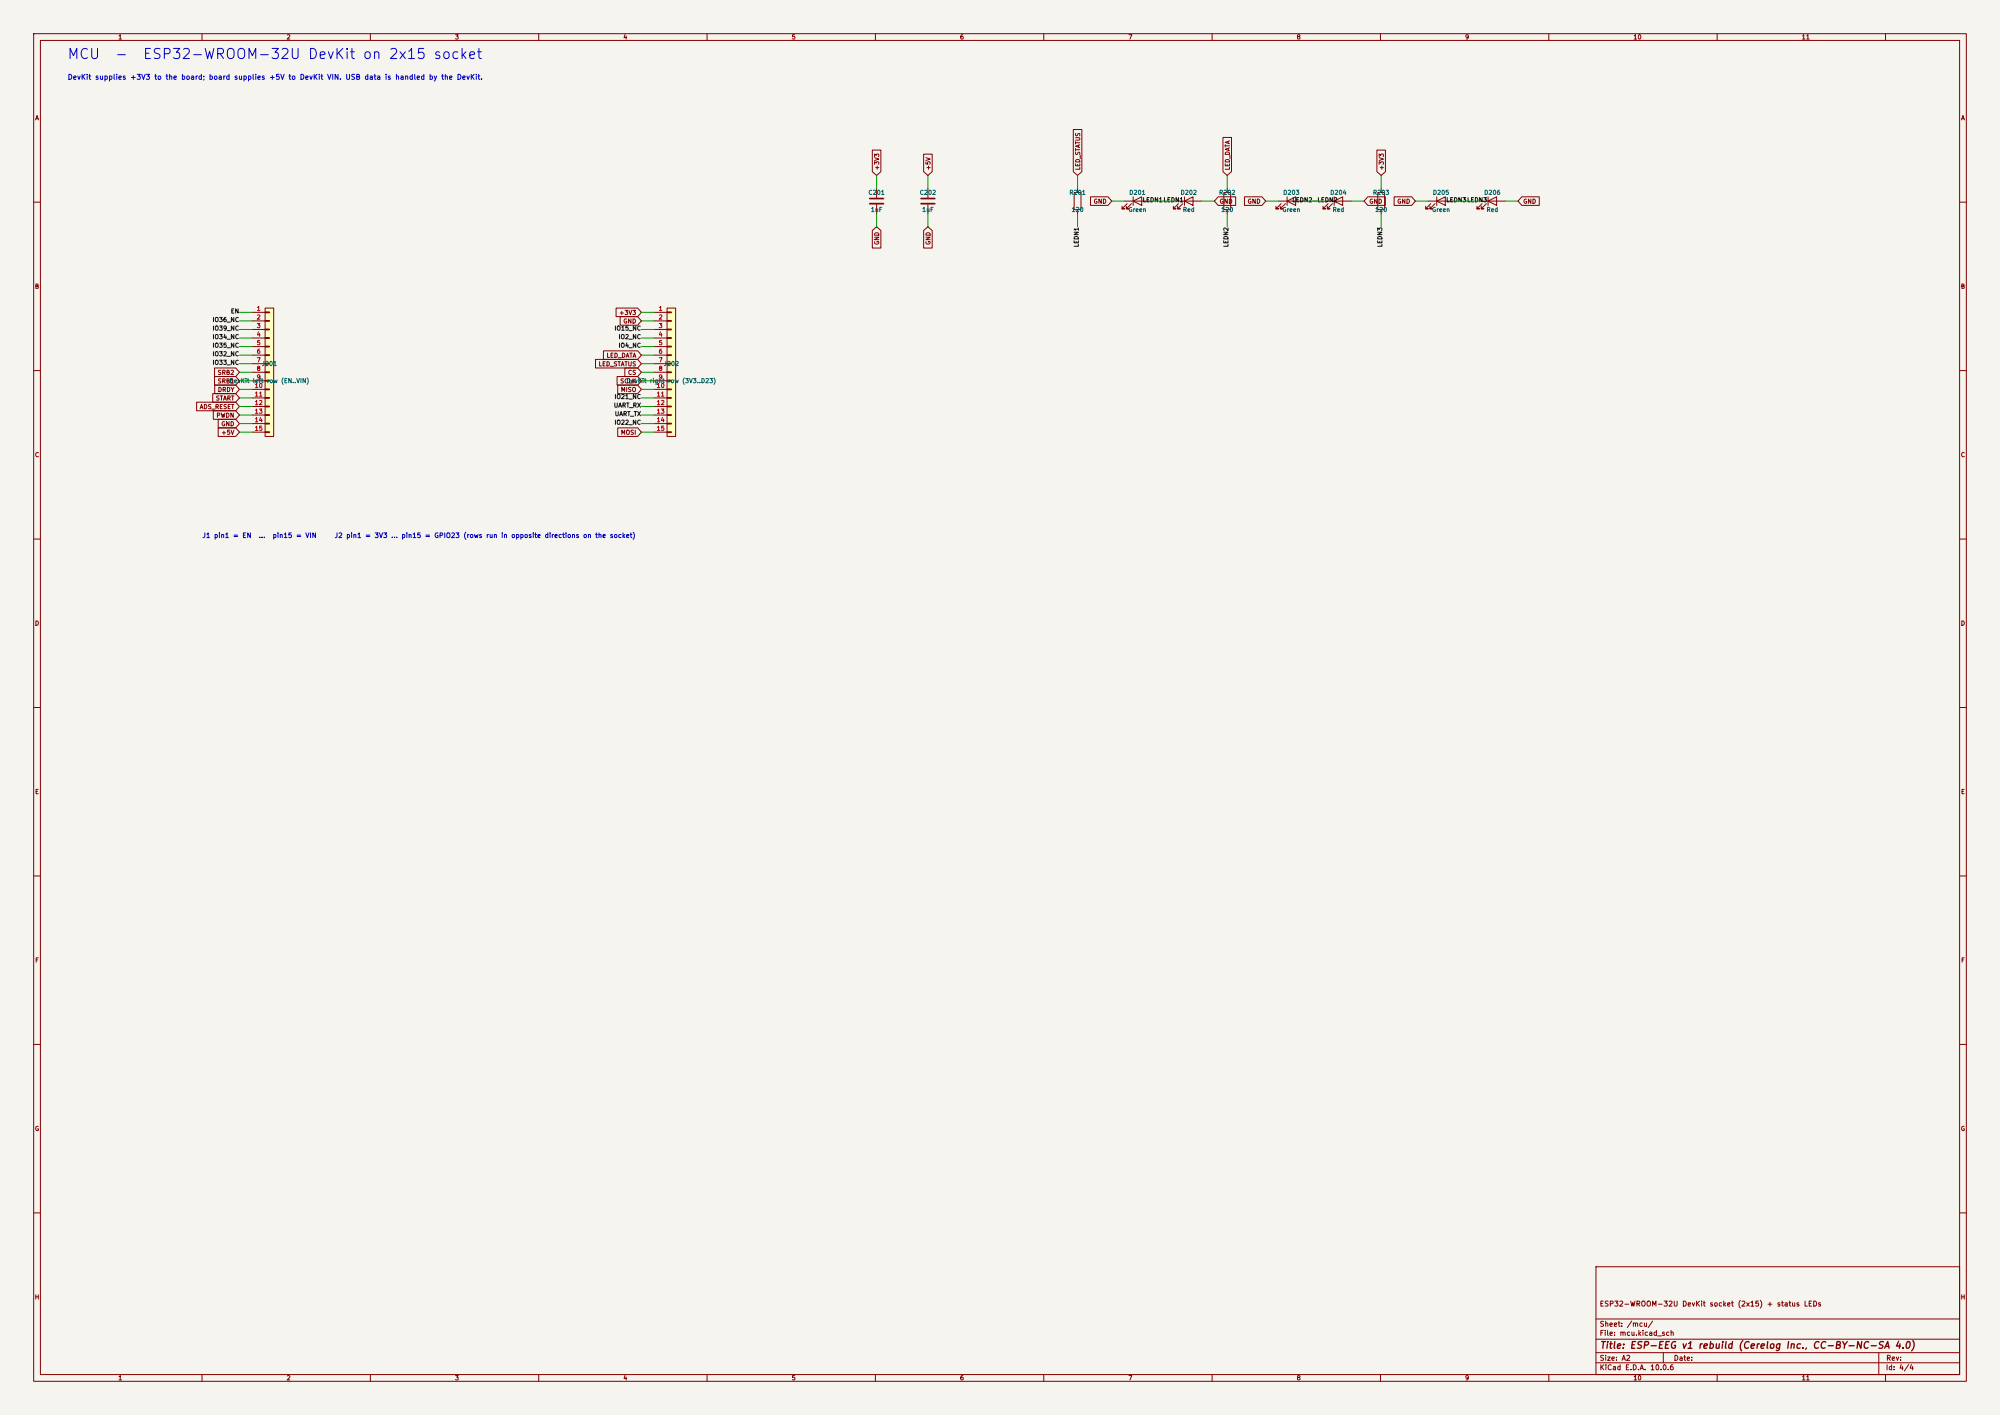
[picture p46: page 4]

MCU - ESP32-WROOM-32U DevKit on 2x15 socket

DevKit supplies +3V3 to the board; board supplies +5V to DevKit VIN. USB data is handled by the DevKit.

ESP32-WROOM-32U DevKit socket (2x15) + status LEDs
