irsad-najib/capstone/neurosound-backend/openapi.yaml

openapi: 3.0.3
info:
  title: Neurosound ABR Backend
  version: 1.0.0
  description: |
    Backend Go + Python DSP untuk sistem ABR berbasis ESP32.

    **Koneksi ESP32 (WebSocket):** `wss://capstone.irsad.site/ws?id=<device_id>`
    (lokal: `ws://localhost:8080/ws?id=<device_id>`).

    Frame dari ESP32 (satu objek atau array/batch):
    ```json
    {"ch1":12345,"ch2":-4321,"ts":1234567890,"stim":true}
    ```
    Format ringkas juga diterima: `{"r":12345,"t":1234567890,"s":1}`.

    Pesan bertipe dari ESP32 (tidak masuk ke data ABR):
    `{"type":"log","lines":[...]}` dan `{"type":"audio_test",...}`.

    Perintah dari backend ke ESP32 dikirim lewat WebSocket yang sama:
    `{"type":"command","cmd":"l -30"}` (lihat `/api/v1/command`).

    Endpoint log & perintah butuh token kalau `LOG_TOKEN` diset: klik **Authorize**.
servers:
  - url: /
tags:
  - name: Sistem
  - name: ESP32
    description: Kirim perintah / parameter ke ESP32 yang terhubung
  - name: Log
    description: Log ESP32 (halaman live di `/logs`)
  - name: ABR
  - name: Sesi
  - name: Dummy
    description: Data ABR sintetis dari server (halaman admin)
paths:
  /api/v1/health:
    get:
      tags: [Sistem]
      summary: Cek backend hidup
      responses:
        "200":
          description: OK
          content:
            application/json:
              example: {status: ok, time: "2026-10-21T06:20:50Z", uptime_s: 3600, mongo: true}
  /api/v1/devices:
    get:
      tags: [ESP32]
      summary: Daftar ESP32 terhubung + status terakhir per device
      responses:
        "200":
          description: "`devices` = id yang sedang terhubung; `detail` = semua device yang pernah terlihat"
          content:
            application/json:
              example:
                devices: [esp32-audio-001]
                detail:
                  - id: esp32-audio-001
                    connected: true
                    connections: 1
                    last_seen: "2026-10-21T13:20:50.123+07:00"
                    audio_test: {type: audio_test, device: esp32-audio-001, seq: 12, uptime_ms: 60000, "on": true, freq: 1000, level_dbfs: -20, ch: L+R}
                    audio_test_at: "2026-10-21T13:20:48.001+07:00"
                    frames: 960000
                    last_frame_at: "2026-10-21T13:20:50.120+07:00"
  /api/v1/stim/set:
    post:
      tags: [ESP32]
      summary: Set level stimulus (dB)
      description: Meneruskan `{"cmd":"set_db","value":<db>}` ke semua ESP32.
      requestBody:
        required: true
        content:
          application/json:
            schema:
              type: object
              properties:
                db: {type: integer, minimum: 0, maximum: 120, example: 60}
      responses:
        "200":
          description: Terkirim (`sent` = jumlah ESP32 yang menerima); level disimpan di status stimulus
          content:
            application/json:
              example: {ok: true, db: 60, sent: 1}
        "400":
          description: Body bukan JSON atau db di luar 0..120
  /api/v1/stim/start:
    post:
      tags: [ESP32]
      summary: Mulai stimulus
      description: Mengirim `{"type":"command","cmd":"on"}` ke semua ESP32 dan menandai stimulus berjalan.
      responses:
        "200":
          description: OK
          content:
            application/json:
              example: {ok: true, sent: 1, running: true, db: 80, started_at: "2026-10-21T06:20:50Z"}
  /api/v1/stim/stop:
    post:
      tags: [ESP32]
      summary: Hentikan stimulus
      description: Mengirim `{"type":"command","cmd":"off"}` ke semua ESP32.
      responses:
        "200":
          description: OK
          content:
            application/json:
              example: {ok: true, sent: 1, running: false, db: 80}
  /api/v1/command:
    post:
      tags: [ESP32]
      summary: Kirim perintah konsol ke ESP32
      description: |
        Dikirim ke ESP sebagai `{"type":"command","cmd":"<cmd>"}`.
        Perintah ESP audio: `f <Hz>`, `l <dBFS>`, `on`, `off`, `c L/R/B`, `s`, `p`, `net`, `?`.
        `device` kosong = kirim ke semua device.
      security: [{logToken: []}, {logTokenQuery: []}]
      requestBody:
        required: true
        content:
          application/json:
            schema:
              type: object
              required: [cmd]
              properties:
                device: {type: string, example: esp32-audio-001}
                cmd: {type: string, example: "l -30"}
      responses:
        "200":
          description: Terkirim (`sent` = jumlah koneksi yang menerima)
          content:
            application/json:
              example: {ok: true, sent: 1}
        "400":
          description: Body bukan JSON atau `cmd` kosong
        "401":
          description: Token salah (hanya jika LOG_TOKEN diset)
        "404":
          description: Device tidak terhubung
          content:
            application/json:
              example: {ok: false, error: device tidak terhubung, device: esp32-audio-001}
  /api/v1/broadcast:
    get:
      tags: [ESP32]
      summary: Broadcast perintah ke semua ESP32 (query)
      security: [{logToken: []}, {logTokenQuery: []}]
      parameters:
        - name: msg
          in: query
          required: true
          schema: {type: string, example: "l -10"}
      responses:
        "200":
          description: Terkirim sebagai `{"type":"command","cmd":msg}`
          content:
            application/json:
              example: {ok: true, msg: "l -10", sent: 1}
        "400":
          description: msg kosong
    post:
      tags: [ESP32]
      summary: Broadcast perintah ke semua ESP32 (JSON)
      security: [{logToken: []}, {logTokenQuery: []}]
      requestBody:
        required: true
        content:
          application/json:
            schema:
              type: object
              properties:
                msg: {type: string, example: "off"}
      responses:
        "200":
          description: Terkirim sebagai `{"type":"command","cmd":msg}`
          content:
            application/json:
              example: {ok: true, msg: "off", sent: 1}
  /api/v1/dummy:
    get:
      tags: [Dummy]
      summary: Status generator data dummy
      security: [{logToken: []}, {logTokenQuery: []}]
      responses:
        "200":
          description: OK
          content:
            application/json:
              example: {running: true, options: {stims: 600, noise_uv: 4, mains_uv: 1.5, no_response: false, reset: true}, started_at: "2026-10-22T04:30:00Z", frames: 160000, stims: 110}
  /api/v1/dummy/sources:
    get:
      tags: [Dummy]
      summary: Daftar sumber dummy (synthetic + rekaman .npz di server)
      description: |
        Rekaman dibaca dari MongoDB GridFS (lihat `/dummy/upload`); kalau MongoDB kosong atau
        tidak tersambung, dari folder `DUMMY_DIR` (default `abr/dummy`, hasil `abr/abr_dummy.py`).
        Ground truth per level dari `ground_truth.json`. `storage` tiap rekaman: `mongodb` atau `dir`.
      security: [{logToken: []}, {logTokenQuery: []}]
      responses:
        "200":
          description: OK (`error` terisi kalau folder rekaman tidak bisa dibaca)
          content:
            application/json:
              example:
                sources: [synthetic]
                dir: /app/dummy-data
                threshold_db: 25
                recordings:
                  - file: abr_dummy_80dB.npz
                    level_db: 80
                    fs: 20000
                    sweeps: 2000
                    duration_s: 95.2
                    ground_truth:
                      waves: {I: {latency_ms: 1.6, amplitude_uv: 0.3}, III: {latency_ms: 3.7, amplitude_uv: 0.25}, V: {latency_ms: 5.576, amplitude_uv: 0.473}}
                      artifact_sweeps: 86
  /api/v1/dummy/start:
    post:
      tags: [Dummy]
      summary: Mulai data ABR dummy di server (sintetis atau replay rekaman)
      description: |
        `source: "synthetic"` membangkitkan sinyal 15 kHz (Wave I/III/V di 1.6/3.7/5.6 ms + noise + 50 Hz).
        `source: "<file>.npz"` memutar rekaman dari `/api/v1/dummy/sources` (di-resample ke 15 kHz,
        diulang kalau `stims` melebihi jumlah sweep; noise_uv/mains_uv/no_response diabaikan).
        Sinyal masuk ke processor lewat jalur yang sama dengan frame ESP32.
        Kalau DSP lebih lambat dari real-time, generator ikut melambat.
      security: [{logToken: []}, {logTokenQuery: []}]
      requestBody:
        required: false
        content:
          application/json:
            schema:
              type: object
              properties:
                source: {type: string, default: synthetic, example: abr_dummy_80dB.npz}
                stims: {type: integer, default: 0, description: "0 = jalan terus sampai /dummy/stop"}
                noise_uv: {type: number, default: 4}
                mains_uv: {type: number, default: 1.5}
                no_response: {type: boolean, default: false, description: "Tanpa ABR → verdict Refer"}
                reset: {type: boolean, default: true, description: "Reset rata-rata sebelum mulai"}
                random_start: {type: boolean, default: false, description: "Rekaman saja — mulai dari sweep acak (indeksnya di status.start_sweep) supaya tiap play berbeda"}
      responses:
        "200":
          description: Berjalan (status generator)
        "400":
          description: Body bukan JSON, atau replay tidak aktif (DUMMY_DIR kosong)
        "404":
          description: Rekaman tidak ditemukan
        "409":
          description: Dummy sudah berjalan
  /api/v1/dummy/upload:
    post:
      tags: [Dummy]
      summary: Upload rekaman dummy (.npz) / ground_truth.json ke MongoDB GridFS
      description: |
        Multipart, field `file` boleh diulang. File `.npz` (keluaran abr/abr_dummy.py, maks 64 MB)
        disimpan utuh di GridFS bucket `dummy`, info-nya di collection `dummy_recordings`;
        nama yang sama diganti. `ground_truth.json` diringkas per level ke `dummy_meta`.
        Kalau MongoDB berisi rekaman, `/dummy/sources` memakai MongoDB; folder DUMMY_DIR hanya cadangan.
        Contoh: `curl -H "X-Log-Token: …" -F file=@abr_dummy_80dB.npz -F file=@ground_truth.json …/api/v1/dummy/upload`
      security: [{logToken: []}, {logTokenQuery: []}]
      requestBody:
        required: true
        content:
          multipart/form-data:
            schema:
              type: object
              properties:
                file:
                  type: array
                  items: {type: string, format: binary}
      responses:
        "200":
          description: Minimal satu file tersimpan
          content:
            application/json:
              example: {ok: true, uploaded: [{file: abr_dummy_80dB.npz, size: 6791464, level_db: 80, sweeps: 2000}, {file: ground_truth.json, size: 12164}], errors: {}}
        "400":
          description: MongoDB tidak aktif, nama file salah, atau isi bukan .npz yang valid
  /api/v1/dummy/stop:
    post:
      tags: [Dummy]
      summary: Hentikan data dummy
      security: [{logToken: []}, {logTokenQuery: []}]
      responses:
        "200":
          description: Status setelah berhenti
  /api/v1/logs:
    get:
      tags: [Log]
      summary: Baris log ESP32 terakhir (maks 1000 per device)
      security: [{logToken: []}, {logTokenQuery: []}]
      parameters:
        - name: device
          in: query
          description: Kosong = semua device digabung urut waktu
          schema: {type: string, example: esp32-audio-001}
        - name: limit
          in: query
          schema: {type: integer, default: 200}
      responses:
        "200":
          description: OK
          content:
            application/json:
              example:
                device: esp32-audio-001
                lines:
                  - {t: "2026-10-21T13:20:50.123+07:00", device: esp32-audio-001, line: "[ 12770 ms] [WS    ] terhubung"}
  /api/v1/logs/stream:
    get:
      tags: [Log]
      summary: Log live (Server-Sent Events, satu event per baris)
      description: "Heartbeat `: ping` tiap 15 detik. Buka lewat halaman `/logs`."
      security: [{logToken: []}, {logTokenQuery: []}]
      parameters:
        - name: device
          in: query
          schema: {type: string}
      responses:
        "200":
          description: text/event-stream
  /api/v1/abr:
    get:
      tags: [ABR]
      summary: Hasil rata-rata ABR saat ini
      responses:
        "200":
          description: OK
          content:
            application/json:
              schema: {$ref: "#/components/schemas/Result"}
  /api/results:
    get:
      tags: [ABR]
      summary: Analisis gelombang (I, III, V) saat ini
      responses:
        "200":
          description: OK
          content:
            application/json:
              schema: {$ref: "#/components/schemas/Analysis"}
  /api/v1/abr/stream:
    get:
      tags: [ABR]
      summary: Stream ABR (Server-Sent Events, tiap 2 detik)
      description: Buka di browser / EventSource; Swagger tidak bisa menampilkan stream.
      responses:
        "200":
          description: text/event-stream
  /api/v1/raw/stream:
    get:
      tags: [ABR]
      summary: Stream sinyal mentah (Server-Sent Events, tiap 200 ms)
      responses:
        "200":
          description: text/event-stream
  /api/v1/reset:
    post:
      tags: [ABR]
      summary: Reset rata-rata ABR (mulai hitung dari 0)
      responses:
        "200":
          description: OK
          content:
            application/json:
              example: {ok: true}
  /api/v1/stim:
    get:
      tags: [ESP32]
      summary: Status stimulus
      description: Status perintah terakhir dari dashboard (firmware tidak mengirim konfirmasi).
      responses:
        "200":
          description: OK
          content:
            application/json:
              example: {running: true, db: 80, started_at: "2026-10-21T06:20:50Z", stim_count: 1250, trials: 1200}
    post:
      tags: [ABR]
      summary: Jumlah trial saat ini
      responses:
        "200":
          description: OK
          content:
            application/json:
              example: {ok: true, trials: 1200}
  /api/v1/abr/save:
    post:
      tags: [Sesi]
      summary: Simpan hasil ABR saat ini sebagai sesi
      requestBody:
        required: false
        content:
          application/json:
            schema:
              type: object
              properties:
                ear: {type: string, enum: [left, right]}
                device: {type: string, example: esp32-abr-001}
                stim_db: {type: integer, example: 80, description: "Kosong = level dari status stimulus"}
                note: {type: string}
      responses:
        "200":
          description: Tersimpan
          content:
            application/json:
              example: {ok: true, file: "eeg_abr_1792988450.json"}
        "400":
          description: ear bukan left/right
  /api/v1/sessions:
    get:
      tags: [Sesi]
      summary: Daftar sesi tersimpan
      responses:
        "200":
          description: OK
          content:
            application/json:
              example: {sessions: [], total: 0}
  /api/v1/sessions/{filename}:
    get:
      tags: [Sesi]
      summary: Detail satu sesi
      parameters:
        - name: filename
          in: path
          required: true
          schema: {type: string}
      responses:
        "200":
          description: OK
        "404":
          description: Sesi tidak ditemukan
components:
  securitySchemes:
    logToken: {type: apiKey, in: header, name: X-Log-Token}
    logTokenQuery: {type: apiKey, in: query, name: token}
  schemas:
    Analysis:
      type: object
      properties:
        waves:
          type: array
          items: {type: object}
        interpeak_ms:
          type: object
          additionalProperties: {type: number}
        verdict: {type: string, enum: [Pass, Refer]}
        normal:
          type: boolean
          description: |
            Klasifikasi ya/tidak. `true` kalau verdict Pass dan semua interpeak di dalam
            rentang normal dewasa (mean ± 2 SD, click 85 dB nHL):
            I-III 2.13 ± 0.14 (1.85–2.41 ms), III-V 1.85 ± 0.18 (1.49–2.21 ms),
            I-V 3.98 ± 0.21 (3.56–4.40 ms). Norma dewasa, bukan bayi.
        reasons:
          type: array
          items: {type: string}
          description: Alasan kalau normal = false (kosong kalau normal)
          example: ["interpeak I-V 4.62 ms di luar normal 3.56–4.40 ms"]
    Result:
      type: object
      properties:
        trial_count: {type: integer}
        abr_average:
          type: array
          items:
            type: array
            items: {type: number}
        sampling_rate: {type: integer, example: 15000}
        epoch_ms: {type: number, example: 60}
        pre_stim_ms: {type: number, example: 10, description: "Bagian epoch sebelum stimulus; abr_average[i] ada di t = i/fs - pre_stim_ms"}
        stim_count: {type: integer, description: Jumlah penanda stimulus yang diterima sejak reset}
        frame_count: {type: integer, description: Jumlah frame yang diterima sejak reset}
        quality: {type: string}
        status: {type: string}
        snr:
          type: array
          items: {type: number}
        pearson_r: {type: number}
        analysis: {$ref: "#/components/schemas/Analysis"}
