irsad-najib/capstone/esp-ads1256/src/net.c

/* Konektivitas: WiFi STA dengan fallback AP + captive portal, lalu WebSocket
 * (TLS) ke backend lewat Cloudflare.
 *
 * Urutan boot:
 *   1. DEFAULT_SSID (hotspot uji) lebih dulu, lalu kredensial dari NVS ("wifi-cfg")
 *   2. Semua gagal dalam STA_TIMEOUT_MS → AP "ESP32-Setup" / "12345678"
 *      + DNS hijack + portal di http://4.3.2.1. Simpan → restart
 *   3. Dapat IP → buka NET_WS_URI. Reconnect WiFi & WS otomatis
 *
 * Probe captive portal: Android /generate_204, iOS /hotspot-detect.html,
 * Windows /ncsi.txt & /connecttest.txt — semua (dan URL lain) di-redirect ke /.
 * IP AP sengaja 4.3.2.1 (bukan 192.168.4.1): Android baru menganggap jawaban
 * DNS berupa IP privat untuk connectivitycheck.gstatic.com sebagai "tanpa
 * internet" dan tidak pernah mengirim /generate_204. Trik yang sama dipakai WLED.
 *
 * Sengaja TANPA DHCP option 114 (RFC 8910): Android 16 (Samsung A35) yang
 * mendapat URI http di option itu berhenti mengirim /generate_204 dan
 * langsung menandai "Connected without internet".
 *
 * Scan WiFi dilakukan sekali sebelum AP aktif (atau lewat /scan): scan saat
 * ada klien membuat AP pindah channel dan HP bisa lepas.
 */

#include "net.h"

#include <stdio.h>
#include <stdlib.h>
#include <string.h>
#include <ctype.h>
#include <stdarg.h>
#include "freertos/FreeRTOS.h"
#include "freertos/task.h"
#include "freertos/event_groups.h"
#include "freertos/semphr.h"
#include "ping/ping_sock.h"
#include "esp_wifi.h"
#include "esp_event.h"
#include "esp_netif.h"
#include "esp_http_server.h"
#include "esp_websocket_client.h"
#include "esp_crt_bundle.h"
#include "esp_system.h"
#include "esp_timer.h"
#include "esp_log.h"
#include "nvs_flash.h"
#include "nvs.h"
#include "lwip/sockets.h"
#include "lwip/tcp.h"

#define AP_SSID          "ESP32-Setup"
#define AP_PASS          "12345678"
/* Hotspot uji, dicoba lebih dulu (lalu kredensial NVS, lalu portal). Diisi lewat
 * src/wifi_default.h (di-gitignore, contoh: wifi_default.example.h); kosong = lewati. */
#if __has_include("wifi_default.h")
#include "wifi_default.h"
#else
#define DEFAULT_SSID     ""
#define DEFAULT_PASS     ""
#endif
#define STA_TIMEOUT_MS   15000
#define NVS_NS           "wifi-cfg"
#define PORTAL_IP_BYTES  4, 3, 2, 1          /* jawaban DNS */
#define PORTAL_IP_ADDR   ESP_IP4TOADDR(4, 3, 2, 1)
#define PORTAL_URL       "http://4.3.2.1/"


#define BIT_GOT_IP  BIT0

static EventGroupHandle_t               net_events;
static esp_netif_t                     *sta_netif;
static esp_netif_t                     *ap_netif;
static esp_websocket_client_handle_t    ws;
static net_cmd_cb_t                     cmd_cb;
static bool                             portal_mode;
static bool                             ever_connected;
static char                             cur_ssid[33];
static uint32_t                         ws_connects, ws_rx, ws_tx;

/* ------------------------------------------------------------------ */
/*  NVS                                                                */
/* ------------------------------------------------------------------ */
static bool load_creds(char *ssid, size_t ssid_sz, char *pass, size_t pass_sz)
{
    nvs_handle_t h;
    if (nvs_open(NVS_NS, NVS_READONLY, &h) != ESP_OK) return false;
    bool ok = nvs_get_str(h, "ssid", ssid, &ssid_sz) == ESP_OK && ssid[0];
    if (ok && nvs_get_str(h, "pass", pass, &pass_sz) != ESP_OK) pass[0] = '\0';
    nvs_close(h);
    return ok;
}

static void save_creds(const char *ssid, const char *pass)
{
    nvs_handle_t h;
    ESP_ERROR_CHECK(nvs_open(NVS_NS, NVS_READWRITE, &h));
    nvs_set_str(h, "ssid", ssid);
    nvs_set_str(h, "pass", pass);
    nvs_commit(h);
    nvs_close(h);
}

void net_forget_wifi(void)
{
    nvs_flash_init();   /* aman dipanggil sebelum net_start() */
    nvs_handle_t h;
    if (nvs_open(NVS_NS, NVS_READWRITE, &h) == ESP_OK) {
        nvs_erase_all(h);
        nvs_commit(h);
        nvs_close(h);
    }
    LOG("NVS", "kredensial WiFi dihapus, restart...");
    esp_restart();
}

/* ------------------------------------------------------------------ */
/*  WebSocket                                                          */
/* ------------------------------------------------------------------ */
/* Ambil nilai string "key":"value" dari JSON sederhana (tanpa escape). */
static bool json_str(const char *js, int len, const char *key, char *out, size_t out_sz)
{
    char pat[24];
    snprintf(pat, sizeof(pat), "\"%s\":\"", key);
    const char *p = strstr(js, pat);
    if (!p || p >= js + len) return false;
    p += strlen(pat);
    size_t n = 0;
    while (p < js + len && *p != '"' && n < out_sz - 1) out[n++] = *p++;
    out[n] = '\0';
    return true;
}

/* esp_websocket_client menulis header dan payload frame dalam dua write. Dengan Nagle,
 * write kedua ditahan sampai header di-ACK (delayed ACK server ~40-100 ms), jadi
 * hanya ~11 pesan/s lewat (perlu 100/s untuk 15 kSPS). Library tidak membuka socket-nya,
 * jadi TCP_NODELAY dipasang di semua socket TCP yang terbuka (mode STA: hanya WS ini). */
static int set_nodelay_all(void)
{
    int n = 0;
    for (int fd = LWIP_SOCKET_OFFSET; fd < LWIP_SOCKET_OFFSET + CONFIG_LWIP_MAX_SOCKETS; fd++) {
        int type = 0, one = 1;
        socklen_t len = sizeof(type);
        if (getsockopt(fd, SOL_SOCKET, SO_TYPE, &type, &len) != 0 || type != SOCK_STREAM) continue;
        if (setsockopt(fd, IPPROTO_TCP, TCP_NODELAY, &one, sizeof(one)) == 0) n++;
    }
    return n;
}

static void ws_event(void *arg, esp_event_base_t base, int32_t id, void *data)
{
    (void)arg; (void)base;
    esp_websocket_event_data_t *ev = data;

    switch (id) {
    case WEBSOCKET_EVENT_CONNECTED:
        ws_connects++;
        LOG("WS", "terhubung ke %s  (TCP_NODELAY %d socket)", NET_WS_URI, set_nodelay_all());
        break;
    case WEBSOCKET_EVENT_DISCONNECTED:
        LOG("WS", "terputus, reconnect otomatis");
        break;
    case WEBSOCKET_EVENT_ERROR:
        LOG("WS", "error transport/TLS");
        break;
    case WEBSOCKET_EVENT_DATA: {
        if (ev->op_code != 0x1 || ev->data_len <= 0) break;   /* teks saja */
        ws_rx++;
        /* Pesan kecil, NUL-terminate di salinan lokal supaya strstr aman. */
        char msg[512];
        int  n = ev->data_len < (int)sizeof(msg) - 1 ? ev->data_len : (int)sizeof(msg) - 1;
        memcpy(msg, ev->data_ptr, n);
        msg[n] = '\0';

        /* Backend membalas ack berisi pesan kita → hitung round-trip. */
        const char *up = strstr(msg, "\"uptime_ms\":");
        if (strstr(msg, "\"type\":\"ack\"") && up) {
            long long sent = atoll(up + 12);
            LOG("WS", "ack  rtt=%lld ms", esp_timer_get_time() / 1000 - sent);
            break;
        }

        char type[16], cmd[64];
        if (json_str(msg, n, "type", type, sizeof(type)) && !strcmp(type, "command") &&
            json_str(msg, n, "cmd", cmd, sizeof(cmd))) {
            LOG("WS", "command dari backend: \"%s\"", cmd);
            if (cmd_cb) cmd_cb(cmd);
            break;
        }
        const char *val = strstr(msg, "\"value\":");
        if (strstr(msg, "\"cmd\":\"set_db\"") && val) {
            snprintf(cmd, sizeof(cmd), "db %d", atoi(val + 8));
            LOG("WS", "set_db dari backend → \"%s\"", cmd);
            if (cmd_cb) cmd_cb(cmd);
            break;
        }
        LOG("WS", "rx: %.*s", n > 160 ? 160 : n, msg);
        break;
    }
    default:
        break;
    }
}

static void ws_start(void)
{
    if (ws) return;
    esp_websocket_client_config_t cfg = {
        .uri                  = NET_WS_URI,
        .crt_bundle_attach    = esp_crt_bundle_attach,
        .reconnect_timeout_ms = 5000,
        .network_timeout_ms   = 10000,
        .ping_interval_sec    = 15,   /* Cloudflare menutup koneksi idle */
        .task_stack           = 6144,
        .buffer_size          = 6144,   /* > satu paket v3 (~4.6 KB): satu frame, tidak dipecah */
        /* Core 1 hampir penuh oleh akuisisi ADS (15k RDATA/s); TLS di sana membuat IDLE1
         * kelaparan (task_wdt) dan WS putus. Satukan dengan WiFi & send_task di core 0. */
        .task_core_id_set     = true,
        .task_core_id         = 0,
    };
    ws = esp_websocket_client_init(&cfg);
    esp_websocket_register_events(ws, WEBSOCKET_EVENT_ANY, ws_event, NULL);
    esp_websocket_client_start(ws);
    LOG("WS", "membuka %s", NET_WS_URI);
}

bool net_ws_connected(void)
{
    return ws && esp_websocket_client_is_connected(ws);
}

bool net_ws_send(const char *text, size_t len)
{
    if (!net_ws_connected()) return false;
    bool ok = esp_websocket_client_send_text(ws, text, len, pdMS_TO_TICKS(1000)) >= 0;
    if (ok) ws_tx++;
    return ok;
}

bool net_ws_send_bin(const void *data, size_t len)
{
    if (!net_ws_connected()) return false;
    /* Timeout di tengah frame meninggalkan pesan setengah terkirim dan server memutus
     * koneksi; lebih baik menunggu (antrian paket menampung 600 ms) daripada memotong. */
    return esp_websocket_client_send_bin(ws, data, len, pdMS_TO_TICKS(5000)) >= 0;
}

/* ------------------------------------------------------------------ */
/*  WiFi events                                                        */
/* ------------------------------------------------------------------ */
static void wifi_event(void *arg, esp_event_base_t base, int32_t id, void *data)
{
    (void)arg;
    if (base == WIFI_EVENT && id == WIFI_EVENT_STA_START) {
        if (!portal_mode) esp_wifi_connect();
    } else if (base == WIFI_EVENT && id == WIFI_EVENT_STA_DISCONNECTED) {
        xEventGroupClearBits(net_events, BIT_GOT_IP);
        if (portal_mode) return;
        wifi_event_sta_disconnected_t *d = data;
        LOG("WIFI", "terputus (reason %d), coba lagi", d->reason);
        esp_wifi_connect();
    } else if (base == IP_EVENT && id == IP_EVENT_STA_GOT_IP) {
        ip_event_got_ip_t *e = data;
        LOG("WIFI", "terhubung ke \"%s\"  IP " IPSTR, cur_ssid, IP2STR(&e->ip_info.ip));
        ever_connected = true;
        xEventGroupSetBits(net_events, BIT_GOT_IP);
        ws_start();
    } else if (base == WIFI_EVENT && id == WIFI_EVENT_AP_STACONNECTED) {
        LOG("AP", "klien tersambung ke %s", AP_SSID);
    }
}

static bool sta_connect(const char *ssid, const char *pass)
{
    wifi_config_t wc = { 0 };
    strlcpy((char *)wc.sta.ssid, ssid, sizeof(wc.sta.ssid));
    strlcpy((char *)wc.sta.password, pass, sizeof(wc.sta.password));
    strlcpy(cur_ssid, ssid, sizeof(cur_ssid));

    LOG("WIFI", "konek ke \"%s\"...", ssid);
    portal_mode = true;   /* tahan retry di handler selama ganti config */
    esp_wifi_disconnect();
    esp_err_t err = esp_wifi_set_config(WIFI_IF_STA, &wc);
    portal_mode = false;
    if (err != ESP_OK) LOG("WIFI", "set_config gagal: %s", esp_err_to_name(err));
    esp_wifi_connect();

    EventBits_t bits = xEventGroupWaitBits(net_events, BIT_GOT_IP, pdFALSE, pdTRUE,
                                           pdMS_TO_TICKS(STA_TIMEOUT_MS));
    if (bits & BIT_GOT_IP) return true;
    LOG("WIFI", "gagal konek ke \"%s\"", ssid);
    return false;
}

/* ------------------------------------------------------------------ */
/*  DNS hijack: semua query A dijawab IP portal (4.3.2.1)              */
/* ------------------------------------------------------------------ */
static void dns_task(void *arg)
{
    (void)arg;
    int sock = socket(AF_INET, SOCK_DGRAM, IPPROTO_UDP);
    struct sockaddr_in addr = {
        .sin_family = AF_INET, .sin_port = htons(53), .sin_addr.s_addr = htonl(INADDR_ANY),
    };
    bind(sock, (struct sockaddr *)&addr, sizeof(addr));

    uint8_t pkt[512];
    for (;;) {
        struct sockaddr_in from;
        socklen_t flen = sizeof(from);
        int n = recvfrom(sock, pkt, sizeof(pkt) - 16, 0, (struct sockaddr *)&from, &flen);
        if (n < 12) continue;

        /* Lewati nama di bagian question, lalu QTYPE + QCLASS. */
        int q = 12;
        while (q < n && pkt[q]) q += pkt[q] + 1;
        q += 5;
        if (q > n) continue;
        bool is_a = pkt[q - 4] == 0 && pkt[q - 3] == 1;

        /* Log nama yang ditanya HP (dibatasi supaya log tidak banjir). */
        static int logged;
        if (logged < 40) {
            char name[96];
            int  o = 0;
            for (int i = 12; i < q - 5 && pkt[i] && o < (int)sizeof(name) - 2; ) {
                int l = pkt[i++];
                if (o) name[o++] = '.';
                while (l-- > 0 && i < n && o < (int)sizeof(name) - 1) name[o++] = (char)pkt[i++];
            }
            name[o] = '\0';
            LOG("DNS", "%s %s", is_a ? "A   " : "lain", name);
            if (++logged == 40) LOG("DNS", "(log DNS berikutnya dimatikan)");
        }

        pkt[2] = 0x81; pkt[3] = 0x80;                    /* response, no error */
        pkt[6] = 0; pkt[7] = is_a ? 1 : 0;               /* ANCOUNT */
        pkt[8] = pkt[9] = pkt[10] = pkt[11] = 0;         /* buang NS/AR (EDNS) */
        int len = q;
        if (is_a) {
            const uint8_t ans[] = { 0xC0, 0x0C, 0, 1, 0, 1, 0, 0, 0, 60, 0, 4,
                                    PORTAL_IP_BYTES };
            memcpy(pkt + len, ans, sizeof(ans));
            len += sizeof(ans);
        }
        sendto(sock, pkt, len, 0, (struct sockaddr *)&from, flen);
    }
}

/* ------------------------------------------------------------------ */
/*  Portal HTTP                                                        */
/* ------------------------------------------------------------------ */
/* Tema sama dengan dashboard Neurosound (frontend/src/app/globals.css):
 * token terang + gelap mengikuti prefers-color-scheme HP. Font sistem karena
 * portal dibuka tanpa internet. */
static const char PAGE_HEAD[] =
    "<!doctype html><html lang=id><head><meta charset=utf-8>"
    "<meta name=viewport content='width=device-width,initial-scale=1'>"
    "<meta name=color-scheme content='light dark'>"
    "<title>Neurosound Setup</title><style>"
    ":root{--bg:#faf9fb;--card:#fff;--low:#f4f3f5;--line:#c3c7cd;--tx:#1b1c1d;--mu:#43474c;"
    "--pri:#032034;--onpri:#fff;--sec:#366850;--secbg:#b8efd1;--ring:rgba(3,32,52,.15)}"
    "@media(prefers-color-scheme:dark){:root{--bg:#121315;--card:#1b1c1e;--low:#1f2022;--line:#43474c;"
    "--tx:#e3e2e4;--mu:#c3c7cd;--pri:#b0c9e4;--onpri:#19324a;--sec:#9dd2b5;--secbg:#1e5039;--ring:rgba(176,201,228,.2)}}"
    "*{box-sizing:border-box}"
    "body{margin:0;background:var(--bg);color:var(--tx);"
    "font:15px/1.5 system-ui,-apple-system,'Segoe UI',Roboto,sans-serif;-webkit-text-size-adjust:100%}"
    "main{max-width:420px;margin:0 auto;padding:28px 16px 40px}"
    ".brand{display:flex;align-items:center;gap:10px;margin-bottom:28px;color:var(--mu);font-size:14px}"
    ".brand svg{width:28px;height:28px}.brand b{color:var(--tx);font-weight:600}"
    "h1{font-size:24px;line-height:1.25;font-weight:600;letter-spacing:-.01em;margin:0 0 6px}"
    ".lead{color:var(--mu);margin:0 0 24px}"
    ".hd{display:flex;justify-content:space-between;align-items:baseline;margin:0 0 8px}"
    "h2{font-size:15px;font-weight:600;margin:0}"
    "a{color:var(--pri);font-weight:500;text-decoration:none}"
    ".list{background:var(--card);border:1px solid var(--line);border-radius:16px;overflow:hidden}"
    ".net{display:flex;align-items:center;gap:12px;width:100%;min-height:52px;padding:12px 16px;"
    "background:none;border:0;border-top:1px solid var(--line);color:inherit;font:inherit;text-align:left;cursor:pointer}"
    ".net:first-child{border-top:0}"
    ".net .n{flex:1;min-width:0;overflow:hidden;text-overflow:ellipsis;white-space:nowrap}"
    ".net[aria-pressed=true]{background:var(--low);box-shadow:inset 3px 0 0 var(--sec)}"
    ".lock{width:14px;height:14px;fill:var(--mu);flex:none}"
    ".bars{display:inline-flex;align-items:flex-end;gap:2px;height:14px;flex:none}"
    ".bars i{width:3px;border-radius:1px;background:var(--line)}"
    ".bars i:nth-child(1){height:4px}.bars i:nth-child(2){height:7px}"
    ".bars i:nth-child(3){height:10px}.bars i:nth-child(4){height:14px}"
    ".l1 i:nth-child(-n+1),.l2 i:nth-child(-n+2),.l3 i:nth-child(-n+3),.l4 i{background:var(--sec)}"
    ".empty{padding:20px 16px;color:var(--mu)}"
    ".note{color:var(--mu);font-size:13px;margin:8px 2px 28px}"
    "label{display:block;font-size:14px;font-weight:500;margin:0 0 6px}"
    ".f{margin-bottom:16px}.pw{position:relative}"
    "input{width:100%;height:48px;padding:0 14px;font:inherit;color:var(--tx);background:var(--card);"
    "border:1px solid var(--line);border-radius:10px;outline:none}"
    "input:focus{border-color:var(--pri);box-shadow:0 0 0 3px var(--ring)}"
    ".pw input{padding-right:84px}"
    ".pw button{position:absolute;right:4px;top:4px;height:40px;padding:0 12px;background:none;border:0;"
    "border-radius:8px;color:var(--pri);font:inherit;font-size:14px;font-weight:500;cursor:pointer}"
    ".go{width:100%;height:48px;margin-top:8px;border:0;border-radius:10px;background:var(--pri);"
    "color:var(--onpri);font:inherit;font-weight:600;cursor:pointer}"
    ".go:disabled{opacity:.6}"
    ":focus-visible{outline:2px solid var(--pri);outline-offset:2px}"
    ".ok{display:flex;align-items:center;justify-content:center;width:44px;height:44px;border-radius:50%;"
    "background:var(--secbg);color:var(--sec);font-size:22px;margin-bottom:16px}"
    "</style></head><body><main>"
    "<div class=brand><svg viewBox='0 0 32 32' aria-hidden=true><rect width=32 height=32 rx=8 fill='#1c354a'/>"
    "<path d='M4 19L7 19L9 15L11 19.5L13 18L15 13L17 19L19 17L21 8L23.5 21L25.5 18L28 19' fill=none "
    "stroke='#9dd2b5' stroke-width=1.8 stroke-linecap=round stroke-linejoin=round /></svg>"
    "<span><b>Neurosound</b> perangkat audio</span></div>";

static void html_escape(char *out, size_t out_sz, const char *in)
{
    size_t n = 0;
    for (; *in && n + 6 < out_sz; in++) {
        const char *r = NULL;
        switch (*in) {
        case '&':  r = "&amp;";  break;
        case '<':  r = "&lt;";   break;
        case '>':  r = "&gt;";   break;
        case '"':  r = "&quot;"; break;
        case '\'': r = "&#39;";  break;
        }
        if (r) { strcpy(out + n, r); n += strlen(r); }
        else   out[n++] = *in;
    }
    out[n] = '\0';
}

static void log_req(const char *what, httpd_req_t *req)
{
    char host[64] = "?", accept[48] = "-", ua[48] = "-";
    httpd_req_get_hdr_value_str(req, "Host", host, sizeof(host));
    httpd_req_get_hdr_value_str(req, "Accept", accept, sizeof(accept));
    httpd_req_get_hdr_value_str(req, "User-Agent", ua, sizeof(ua));
    LOG("HTTP", "%-6s %s%s  accept=%s  ua=%s", what, host, req->uri, accept, ua);
}

static bool wants_capport_json(httpd_req_t *req)
{
    char accept[64] = "";
    httpd_req_get_hdr_value_str(req, "Accept", accept, sizeof(accept));
    return strstr(accept, "captive+json") != NULL;
}

static esp_err_t capport_json(httpd_req_t *req)
{
    httpd_resp_set_type(req, "application/captive+json");
    httpd_resp_set_hdr(req, "Cache-Control", "private");
    return httpd_resp_sendstr(req,
        "{\"captive\":true,\"user-portal-url\":\"" PORTAL_URL "\"}");
}

static wifi_ap_record_t recs[16];
static uint16_t         scan_count;

/* Scan blocking ~2 detik. */
static void wifi_scan(void)
{
    wifi_scan_config_t sc = { .show_hidden = false };
    scan_count = 0;
    if (esp_wifi_scan_start(&sc, true) == ESP_OK) {
        scan_count = sizeof(recs) / sizeof(recs[0]);
        esp_wifi_scan_get_ap_records(&scan_count, recs);
    }
    LOG("PORTAL", "scan: %u jaringan", scan_count);
}

static esp_err_t portal_root(httpd_req_t *req)
{
    /* HP yang masih menyimpan URI option 114 lama ("/") meminta JSON di sini. */
    if (wants_capport_json(req)) {
        log_req("api/", req);
        return capport_json(req);
    }
    log_req("page", req);
    httpd_resp_set_type(req, "text/html");
    httpd_resp_send_chunk(req, PAGE_HEAD, HTTPD_RESP_USE_STRLEN);

    httpd_resp_send_chunk(req,
        "<h1>Sambungkan ke WiFi</h1>"
        "<p class=lead>Perangkat butuh WiFi untuk terhubung ke capstone.irsad.site.</p>"
        "<div class=hd><h2>Jaringan terdekat</h2><a href=/scan>Scan ulang</a></div>"
        "<div class=list>", HTTPD_RESP_USE_STRLEN);

    static const char LOCK[] =
        "<svg class=lock viewBox='0 0 24 24' aria-label=terkunci><path d='M17 9h-1V7a4 4 0 0 0-8 0v2H7a2 2 0 0 0-2 2v8"
        "a2 2 0 0 0 2 2h10a2 2 0 0 0 2-2v-8a2 2 0 0 0-2-2zm-7-2a2 2 0 0 1 4 0v2h-4z'/></svg>";
    char line[720], esc[100];
    int shown = 0;
    for (int i = 0; i < scan_count; i++) {
        if (!recs[i].ssid[0]) continue;
        /* SSID sama dari mesh/repeater: tampilkan sekali (hasil scan urut RSSI). */
        bool dup = false;
        for (int j = 0; j < i && !dup; j++) dup = !strcmp((char *)recs[j].ssid, (char *)recs[i].ssid);
        if (dup) continue;

        int rssi  = recs[i].rssi;
        int level = rssi >= -55 ? 4 : rssi >= -67 ? 3 : rssi >= -78 ? 2 : 1;
        html_escape(esc, sizeof(esc), (const char *)recs[i].ssid);
        snprintf(line, sizeof(line),
                 "<button class=net type=button aria-pressed=false data-s=\"%s\">"
                 "<span class=n>%s</span>%s"
                 "<span class='bars l%d' aria-label='sinyal %d dari 4'><i></i><i></i><i></i><i></i></span></button>",
                 esc, esc, recs[i].authmode != WIFI_AUTH_OPEN ? LOCK : "", level, level);
        httpd_resp_send_chunk(req, line, HTTPD_RESP_USE_STRLEN);
        shown++;
    }
    if (shown == 0)
        httpd_resp_send_chunk(req, "<p class=empty>Belum ada WiFi terdeteksi. Scan ulang, atau ketik namanya di bawah.</p>",
                              HTTPD_RESP_USE_STRLEN);

    httpd_resp_send_chunk(req,
        "</div><p class=note>Hanya WiFi 2.4 GHz. Scan ulang bisa memutus HP sebentar.</p>"
        "<form method=post action=/save id=f>"
        "<div class=f><label for=s>Nama WiFi</label>"
        "<input id=s name=ssid required maxlength=32 autocomplete=off autocapitalize=none></div>"
        "<div class=f><label for=p>Password</label><div class=pw>"
        "<input id=p name=pass type=password maxlength=63 autocomplete=current-password>"
        "<button type=button id=t aria-controls=p>Lihat</button></div></div>"
        "<button class=go id=g>Simpan &amp; sambungkan</button></form></main>"
        "<script>"
        "var s=document.getElementById('s'),p=document.getElementById('p');"
        "document.querySelectorAll('.net').forEach(function(b){b.onclick=function(){"
        "document.querySelectorAll('.net').forEach(function(x){x.setAttribute('aria-pressed','false')});"
        "b.setAttribute('aria-pressed','true');s.value=b.dataset.s;p.focus()}});"
        "document.getElementById('t').onclick=function(){var h=p.type=='password';"
        "p.type=h?'text':'password';this.textContent=h?'Sembunyikan':'Lihat'};"
        "document.getElementById('f').onsubmit=function(){var g=document.getElementById('g');"
        "g.disabled=true;g.textContent='Menyimpan…'};"
        "</script></body></html>",
        HTTPD_RESP_USE_STRLEN);
    return httpd_resp_send_chunk(req, NULL, 0);
}

static void url_decode(char *s)
{
    char *o = s;
    for (; *s; s++) {
        if (*s == '+') *o++ = ' ';
        else if (*s == '%' && isxdigit((unsigned char)s[1]) && isxdigit((unsigned char)s[2])) {
            char hex[3] = { s[1], s[2], 0 };
            *o++ = (char)strtol(hex, NULL, 16);
            s += 2;
        } else *o++ = *s;
    }
    *o = '\0';
}

static void restart_cb(void *arg) { (void)arg; esp_restart(); }

static esp_err_t portal_save(httpd_req_t *req)
{
    char body[256] = { 0 };
    int  len = req->content_len < (int)sizeof(body) - 1 ? req->content_len : (int)sizeof(body) - 1;
    int  got = 0;
    while (got < len) {
        int r = httpd_req_recv(req, body + got, len - got);
        if (r <= 0) return ESP_FAIL;
        got += r;
    }

    char ssid[100] = { 0 }, pass[200] = { 0 };
    httpd_query_key_value(body, "ssid", ssid, sizeof(ssid));
    httpd_query_key_value(body, "pass", pass, sizeof(pass));
    url_decode(ssid);
    url_decode(pass);
    if (!ssid[0] || strlen(ssid) > 32 || strlen(pass) > 63) {
        httpd_resp_send_err(req, HTTPD_400_BAD_REQUEST, "SSID/password tidak valid");
        return ESP_OK;
    }

    save_creds(ssid, pass);
    LOG("PORTAL", "kredensial \"%s\" disimpan, restart 1 detik lagi", ssid);

    char esc[100], page[640];
    html_escape(esc, sizeof(esc), ssid);
    snprintf(page, sizeof(page),
             "<div class=ok aria-hidden=true>&#10003;</div>"
             "<h1>Tersimpan</h1>"
             "<p class=lead>Perangkat restart dan menyambung ke <b>%s</b>. Halaman ini boleh ditutup.</p>"
             "<p class=note>Kalau gagal tersambung, WiFi ESP32-Setup muncul lagi dalam sekitar 15 detik. "
             "Biasanya karena password salah ketik.</p></main></body></html>", esc);
    httpd_resp_set_type(req, "text/html");
    httpd_resp_send_chunk(req, PAGE_HEAD, HTTPD_RESP_USE_STRLEN);
    httpd_resp_send_chunk(req, page, HTTPD_RESP_USE_STRLEN);
    httpd_resp_send_chunk(req, NULL, 0);

    static esp_timer_handle_t t;
    const esp_timer_create_args_t ta = { .callback = restart_cb, .name = "restart" };
    esp_timer_create(&ta, &t);
    esp_timer_start_once(t, 1000000);
    return ESP_OK;
}

/* Semua probe OS dan URL tak dikenal → redirect ke portal. */
static esp_err_t portal_probe(httpd_req_t *req)
{
    log_req("probe", req);
    httpd_resp_set_status(req, "302 Found");
    httpd_resp_set_hdr(req, "Location", PORTAL_URL);
    httpd_resp_set_hdr(req, "Cache-Control", "no-store");
    httpd_resp_set_type(req, "text/html");
    return httpd_resp_sendstr(req, "<a href='" PORTAL_URL "'>ESP32 Setup</a>");
}

static esp_err_t portal_redirect(httpd_req_t *req, httpd_err_code_t err)
{
    (void)err;
    log_req("404", req);
    return portal_probe(req);
}

static esp_err_t portal_scan(httpd_req_t *req)
{
    wifi_scan();
    httpd_resp_set_status(req, "302 Found");
    httpd_resp_set_hdr(req, "Location", "/");
    return httpd_resp_send(req, NULL, 0);
}

/* RFC 8908: Android 11+ membaca JSON ini dari URI di DHCP option 114. */
static esp_err_t portal_capport_api(httpd_req_t *req)
{
    log_req("api", req);
    return capport_json(req);
}

/* AP pakai IP 4.3.2.1/24; DHCP membagikan DNS = IP itu supaya semua nama
 * mendarat di dns_task. */
static void dhcps_setup(void)
{
    esp_netif_ip_info_t ip = { 0 };
    ip.ip.addr      = PORTAL_IP_ADDR;
    ip.gw.addr      = PORTAL_IP_ADDR;
    ip.netmask.addr = ESP_IP4TOADDR(255, 255, 255, 0);

    esp_netif_dns_info_t dns = { 0 };
    dns.ip.type             = ESP_IPADDR_TYPE_V4;
    dns.ip.u_addr.ip4.addr  = PORTAL_IP_ADDR;
    uint8_t offer_dns = 1;

    esp_netif_dhcps_stop(ap_netif);
    esp_err_t err = esp_netif_set_ip_info(ap_netif, &ip);
    if (err != ESP_OK) LOG("PORTAL", "set IP AP gagal: %s", esp_err_to_name(err));
    esp_netif_set_dns_info(ap_netif, ESP_NETIF_DNS_MAIN, &dns);
    esp_netif_dhcps_option(ap_netif, ESP_NETIF_OP_SET, ESP_NETIF_DOMAIN_NAME_SERVER,
                           &offer_dns, sizeof(offer_dns));
    esp_netif_dhcps_start(ap_netif);
}

static void portal_start(void)
{
    portal_mode = true;
    esp_wifi_disconnect();
    wifi_scan();   /* sebelum AP aktif, supaya klien tidak terputus */

    wifi_config_t ap = {
        .ap = {
            .ssid           = AP_SSID,
            .ssid_len       = sizeof(AP_SSID) - 1,
            .password       = AP_PASS,
            .channel        = 1,
            .max_connection = 4,
            .authmode       = WIFI_AUTH_WPA2_PSK,
        },
    };
    ESP_ERROR_CHECK(esp_wifi_set_mode(WIFI_MODE_APSTA));
    ESP_ERROR_CHECK(esp_wifi_set_config(WIFI_IF_AP, &ap));
    dhcps_setup();

    httpd_handle_t srv;
    httpd_config_t hc = HTTPD_DEFAULT_CONFIG();
    hc.stack_size       = 8192;
    hc.max_uri_handlers = 16;
    hc.lru_purge_enable = true;   /* HP sering buka banyak socket sekaligus */
    ESP_ERROR_CHECK(httpd_start(&srv, &hc));
    const httpd_uri_t root = { .uri = "/",     .method = HTTP_GET,  .handler = portal_root };
    const httpd_uri_t save = { .uri = "/save", .method = HTTP_POST, .handler = portal_save };
    const httpd_uri_t scan = { .uri = "/scan", .method = HTTP_GET,  .handler = portal_scan };
    httpd_register_uri_handler(srv, &root);
    httpd_register_uri_handler(srv, &save);
    httpd_register_uri_handler(srv, &scan);
    const httpd_uri_t api = { .uri = "/captive-portal/api", .method = HTTP_GET,
                              .handler = portal_capport_api };
    httpd_register_uri_handler(srv, &api);

    static const char *probes[] = {
        "/generate_204", "/gen_204",                 /* Android, Samsung */
        "/hotspot-detect.html", "/library/test/success.html",   /* Apple */
        "/ncsi.txt", "/connecttest.txt", "/redirect", /* Windows */
        "/canonical.html", "/success.txt",           /* Firefox, Linux */
    };
    for (size_t i = 0; i < sizeof(probes) / sizeof(probes[0]); i++) {
        const httpd_uri_t u = { .uri = probes[i], .method = HTTP_GET, .handler = portal_probe };
        httpd_register_uri_handler(srv, &u);
    }
    httpd_register_err_handler(srv, HTTPD_404_NOT_FOUND, portal_redirect);

    xTaskCreatePinnedToCore(dns_task, "dns", 3072, NULL, 3, NULL, 1);
    LOG("PORTAL", "AP \"%s\" / \"%s\" aktif → buka " PORTAL_URL, AP_SSID, AP_PASS);
}

/* ------------------------------------------------------------------ */
/*  Public                                                             */
/* ------------------------------------------------------------------ */
static void nvs_ready(void)
{
    esp_err_t err = nvs_flash_init();
    if (err == ESP_ERR_NVS_NO_FREE_PAGES || err == ESP_ERR_NVS_NEW_VERSION_FOUND) {
        nvs_flash_erase();
        err = nvs_flash_init();
    }
    ESP_ERROR_CHECK(err);
}

/* ------------------------------------------------------------------ */
/*  Mode debug                                                         */
/* ------------------------------------------------------------------ */
#define NVS_DEBUG_NS  "debug"
volatile bool net_debug;

void net_debug_load(void)
{
    nvs_ready();
    nvs_handle_t h;
    uint8_t on = 0;
    if (nvs_open(NVS_DEBUG_NS, NVS_READONLY, &h) == ESP_OK) {
        nvs_get_u8(h, "on", &on);
        nvs_close(h);
    }
    net_debug = on;
    if (on) LOG("DEBUG", "mode debug NYALA (matikan: debug off)");
}

void net_debug_set(bool on)
{
    net_debug = on;
    nvs_handle_t h;
    if (nvs_open(NVS_DEBUG_NS, NVS_READWRITE, &h) == ESP_OK) {
        nvs_set_u8(h, "on", on);
        nvs_commit(h);
        nvs_close(h);
    }
    LOG("DEBUG", "mode debug %s (tersimpan, berlaku juga setelah restart)", on ? "NYALA" : "mati");
}

bool net_start(net_cmd_cb_t on_command)
{
    cmd_cb     = on_command;
    net_events = xEventGroupCreate();

    nvs_ready();

    ESP_ERROR_CHECK(esp_netif_init());
    ESP_ERROR_CHECK(esp_event_loop_create_default());
    sta_netif = esp_netif_create_default_wifi_sta();
    ap_netif  = esp_netif_create_default_wifi_ap();

    wifi_init_config_t wic = WIFI_INIT_CONFIG_DEFAULT();
    ESP_ERROR_CHECK(esp_wifi_init(&wic));
    esp_event_handler_register(WIFI_EVENT, ESP_EVENT_ANY_ID, wifi_event, NULL);
    esp_event_handler_register(IP_EVENT, IP_EVENT_STA_GOT_IP, wifi_event, NULL);
    ESP_ERROR_CHECK(esp_wifi_set_storage(WIFI_STORAGE_RAM));
    ESP_ERROR_CHECK(esp_wifi_set_mode(WIFI_MODE_STA));
    ESP_ERROR_CHECK(esp_wifi_set_ps(WIFI_PS_NONE));   /* latensi stabil */
    portal_mode = true;   /* tahan auto-connect di STA_START sampai config diset */
    ESP_ERROR_CHECK(esp_wifi_start());
    portal_mode = false;

    if (DEFAULT_SSID[0] && sta_connect(DEFAULT_SSID, DEFAULT_PASS)) return true;

    char ssid[33] = { 0 }, pass[65] = { 0 };
    if (load_creds(ssid, sizeof(ssid), pass, sizeof(pass))) {
        if (strcmp(ssid, DEFAULT_SSID) != 0 && sta_connect(ssid, pass)) return true;
    } else {
        LOG("WIFI", "belum ada kredensial tersimpan");
    }
    portal_start();
    return false;
}

/* ------------------------------------------------------------------ */
/*  Tes jaringan (tahap 2 boot)                                        */
/* ------------------------------------------------------------------ */
#define TEST_PING_COUNT   10
#define TEST_MIN_KBPS     60.0f   /* kebutuhan ADS ≈ 46 KB/s + margin */
#define TEST_WS_WAIT_MS   10000
#define TEST_SEND_MS      8000
#define TEST_PKT_BYTES    4500
#define TEST_PKT_COUNT    60

typedef struct {
    volatile uint32_t ok, lost, rtt_sum, rtt_max;
    SemaphoreHandle_t done;
} ping_acc_t;

static void ping_ok_cb(esp_ping_handle_t h, void *arg)
{
    ping_acc_t *a = arg;
    uint32_t t = 0;
    esp_ping_get_profile(h, ESP_PING_PROF_TIMEGAP, &t, sizeof(t));
    a->ok++;
    a->rtt_sum += t;
    if (t > a->rtt_max) a->rtt_max = t;
}
static void ping_timeout_cb(esp_ping_handle_t h, void *arg) { (void)h; ((ping_acc_t *)arg)->lost++; }
static void ping_end_cb(esp_ping_handle_t h, void *arg)     { (void)h; xSemaphoreGive(((ping_acc_t *)arg)->done); }

bool net_selftest(void)
{
    bool pass = true;
    LOG("TEST", "=== tes jaringan ===");

    /* 1) WebSocket harus sudah terbuka. */
    int64_t t0 = esp_timer_get_time();
    while (!net_ws_connected() && (esp_timer_get_time() - t0) / 1000 < TEST_WS_WAIT_MS)
        vTaskDelay(pdMS_TO_TICKS(100));
    bool ws_ok = net_ws_connected();
    LOG("TEST", "WS: %s (%.1f s)", ws_ok ? "tersambung" : "BELUM tersambung",
        (esp_timer_get_time() - t0) / 1e6f);
    if (!ws_ok) pass = false;

    /* 2) Ping gateway: loss dan jitter jalur WiFi. */
    esp_netif_ip_info_t ip;
    if (!sta_netif || esp_netif_get_ip_info(sta_netif, &ip) != ESP_OK || ip.gw.addr == 0) {
        LOG("TEST", "ping: tidak ada gateway");
        return false;
    }
    ping_acc_t acc = { .done = xSemaphoreCreateBinary() };
    esp_ping_config_t pc = ESP_PING_DEFAULT_CONFIG();
    pc.count       = TEST_PING_COUNT;
    pc.interval_ms = 100;
    pc.timeout_ms  = 1000;
    pc.task_stack_size = 3072;
    ip_addr_set_ip4_u32(&pc.target_addr, ip.gw.addr);
    esp_ping_callbacks_t cbs = {
        .on_ping_success = ping_ok_cb, .on_ping_timeout = ping_timeout_cb,
        .on_ping_end = ping_end_cb,    .cb_args = &acc,
    };
    esp_ping_handle_t ph;
    if (esp_ping_new_session(&pc, &cbs, &ph) == ESP_OK) {
        esp_ping_start(ph);
        xSemaphoreTake(acc.done, pdMS_TO_TICKS(TEST_PING_COUNT * 1200 + 1000));
        esp_ping_stop(ph);
        esp_ping_delete_session(ph);
        LOG("TEST", "ping gateway " IPSTR ": %lu/%d balasan, rata-rata %lu ms, maks %lu ms",
            IP2STR(&ip.gw), (unsigned long)acc.ok, TEST_PING_COUNT,
            (unsigned long)(acc.ok ? acc.rtt_sum / acc.ok : 0), (unsigned long)acc.rtt_max);
        if (acc.ok < TEST_PING_COUNT) pass = false;
    } else {
        LOG("TEST", "ping: gagal membuat sesi");
        pass = false;
    }
    vSemaphoreDelete(acc.done);

    /* 3) Laju kirim WS: pesan biner dummy (magic 0x00, ditolak backend). */
    if (ws_ok) {
        static uint8_t dummy[TEST_PKT_BYTES];   /* nol semua */
        int sent = 0;
        int64_t ts = esp_timer_get_time();
        for (int i = 0; i < TEST_PKT_COUNT; i++) {
            if ((esp_timer_get_time() - ts) / 1000 > TEST_SEND_MS) break;
            if (!net_ws_send_bin(dummy, sizeof(dummy))) break;
            sent++;
        }
        float el   = (esp_timer_get_time() - ts) / 1e6f;
        float kbps = el > 0 ? sent * (TEST_PKT_BYTES / 1000.0f) / el : 0;
        LOG("TEST", "laju kirim WS: %d/%d pesan 4.5 KB dalam %.2f s = %.0f KB/s (min %.0f)",
            sent, TEST_PKT_COUNT, el, kbps, TEST_MIN_KBPS);
        if (kbps < TEST_MIN_KBPS) pass = false;
    }

    LOG("TEST", "=== hasil: %s ===", pass ? "LOLOS" : "TIDAK LOLOS");
    return pass;
}

/* ------------------------------------------------------------------ */
/*  Log ke backend                                                     */
/* ------------------------------------------------------------------ */
/* Semua baris LOG() dan ESP_LOGx ditampung di ring buffer, lalu dikirim
 * sebagai {"type":"log",...} dari task konsol. Baris dari sebelum WiFi
 * konek ikut terkirim begitu WS tersambung. */
#define LOG_LINES     96
#define LOG_LINE_LEN  160
#define LOG_FLUSH_US  500000
#define LOG_JSON_MAX  1800

static char        log_ring[LOG_LINES][LOG_LINE_LEN];
static int         log_head, log_count;     /* head = baris tertua */
static uint32_t    log_dropped;
static portMUX_TYPE log_mux = portMUX_INITIALIZER_UNLOCKED;
static vprintf_like_t uart_vprintf;

static void log_push(const char *s)
{
    char clean[LOG_LINE_LEN];
    size_t n = 0;
    for (; *s && n < sizeof(clean) - 1; s++) {
        if (*s == '\033') {                    /* buang kode warna ANSI */
            while (*s && *s != 'm') s++;
            if (!*s) break;
            continue;
        }
        if (*s == '\n' || *s == '\r') continue;
        clean[n++] = *s;
    }
    clean[n] = '\0';
    if (n == 0) return;

    portENTER_CRITICAL(&log_mux);
    if (log_count == LOG_LINES) {
        log_head = (log_head + 1) % LOG_LINES;
        log_count--;
        log_dropped++;
    }
    memcpy(log_ring[(log_head + log_count) % LOG_LINES], clean, n + 1);
    log_count++;
    portEXIT_CRITICAL(&log_mux);
}

static int log_vprintf_hook(const char *fmt, va_list args)
{
    char buf[LOG_LINE_LEN];
    va_list copy;
    va_copy(copy, args);
    vsnprintf(buf, sizeof(buf), fmt, copy);
    va_end(copy);
    log_push(buf);
    return uart_vprintf(fmt, args);
}

void net_log_init(void)
{
    uart_vprintf = esp_log_set_vprintf(log_vprintf_hook);
}

void net_logf(const char *fmt, ...)
{
    char buf[LOG_LINE_LEN];
    va_list args;
    va_start(args, fmt);
    vsnprintf(buf, sizeof(buf), fmt, args);
    va_end(args);
    printf("%s\n", buf);
    log_push(buf);
}

static size_t json_escape(char *out, size_t cap, const char *in)
{
    size_t n = 0;
    for (; *in; in++) {
        unsigned char c = (unsigned char)*in;
        if (c == '"' || c == '\\') {
            if (n + 2 >= cap) break;
            out[n++] = '\\';
            out[n++] = (char)c;
        } else if (c < 0x20) {
            if (n + 6 >= cap) break;
            n += snprintf(out + n, cap - n, "\\u%04x", c);
        } else {
            if (n + 1 >= cap) break;
            out[n++] = (char)c;
        }
    }
    out[n] = '\0';
    return n;
}

void net_log_flush(void)
{
    static int64_t next_us;
    static char    js[LOG_JSON_MAX + 64];
    int64_t now = esp_timer_get_time();
    if (now < next_us || !net_ws_connected()) return;
    next_us = now + LOG_FLUSH_US;

    if (log_dropped) {
        uint32_t d = log_dropped;
        log_dropped = 0;
        char msg[64];
        snprintf(msg, sizeof(msg), "[log] %lu baris lama terbuang (buffer penuh)", (unsigned long)d);
        log_push(msg);
    }

    /* Hanya task ini yang mengambil dari ring, jadi baris yang diintip
     * tidak akan hilang kecuali tertimpa karena penuh (dicek ulang saat commit). */
    int  n = snprintf(js, sizeof(js), "{\"type\":\"log\",\"device\":\"%s\",\"ts\":%lld,\"lines\":[",
                      NET_DEVICE_ID, now / 1000);
    int  taken = 0;
    char line[LOG_LINE_LEN], esc[LOG_LINE_LEN * 2];
    for (;;) {
        portENTER_CRITICAL(&log_mux);
        bool have = taken < log_count;
        if (have) memcpy(line, log_ring[(log_head + taken) % LOG_LINES], LOG_LINE_LEN);
        portEXIT_CRITICAL(&log_mux);
        if (!have) break;

        size_t e = json_escape(esc, sizeof(esc), line);
        if (n + (int)e + 4 > LOG_JSON_MAX) break;
        n += snprintf(js + n, sizeof(js) - n, "%s\"%s\"", taken ? "," : "", esc);
        taken++;
    }
    if (taken == 0) return;
    n += snprintf(js + n, sizeof(js) - n, "]}");

    if (!net_ws_send(js, n)) return;   /* gagal → dicoba lagi berikutnya */

    portENTER_CRITICAL(&log_mux);
    if (taken > log_count) taken = log_count;
    log_head  = (log_head + taken) % LOG_LINES;
    log_count -= taken;
    portEXIT_CRITICAL(&log_mux);
}

void net_print_status(void)
{
    if (portal_mode) {
        LOG("NET", "mode portal: AP \"%s\" → " PORTAL_URL, AP_SSID);
        return;
    }
    wifi_ap_record_t ap;
    if (esp_wifi_sta_get_ap_info(&ap) == ESP_OK) {
        esp_netif_ip_info_t ip;
        esp_netif_get_ip_info(sta_netif, &ip);
        LOG("NET", "WiFi \"%s\"  RSSI %d dBm  IP " IPSTR, cur_ssid, ap.rssi, IP2STR(&ip.ip));
    } else {
        LOG("NET", "WiFi \"%s\" belum terhubung%s", cur_ssid, ever_connected ? " (reconnect)" : "");
    }
    LOG("NET", "WS %s  connect=%lu  tx=%lu  rx=%lu  heap=%lu",
        net_ws_connected() ? "ON " : "OFF", (unsigned long)ws_connects,
        (unsigned long)ws_tx, (unsigned long)ws_rx, (unsigned long)esp_get_free_heap_size());
}
