irsad-najib/capstone/esp-ads1256/src/wifi_default.example.h

/* Salin ke wifi_default.h (di-gitignore) dan isi hotspot uji. */
#define DEFAULT_SSID     "nama-hotspot"
#define DEFAULT_PASS     "password"
