irsad-najib/capstone/(commit log)

2026-09-10 chore: bersihkan tracking, absorb nested repo, tulis README
    - .gitignore lengkap: build artifact (.pio/.next/node_modules/.venv),
    binary Go, data sesi, secrets, aset >100MB (*.blend, *.zip),
    dan dokumen LaTeX privat (Dokumen/, c251/)
    - frontend/ dan ads-only/ sebelumnya gitlink rusak (submodule tanpa
    .gitmodules dan tanpa remote) -> di-absorb jadi folder biasa
    - untrack backend/server (11 MB binary), get-platformio.py,
    dan sisa folder "Dokuimen c-251" yang sudah dihapus dari disk
    - README.md: arsitektur, struktur repo, quick start, kontrak data,
    pin hardware, dan daftar yang sengaja tidak di-push
2026-10-21 feat(audio-only): firmware test audio PCM5102A + WiFi portal + WSS ke backend
    Tone generator (dBFS, step level, sweep frekuensi) via serial atau
    command dari backend. WiFi: NVS -> default -> AP ESP32-Setup + captive
    portal. Status dikirim ke wss://capstone.irsad.site/ws tiap 5 detik.
    Pin I2S sesuai skematik board 2: BCK=32, LRCK=33, DIN=14.
2026-10-21 feat(audio-only): perintah i2s untuk diagnostik laju frame & level puncak
    Claude-Session: https://claude.ai/code/session_01EgUZLjeTxBpdG6EczdiALn
2026-10-21 feat(backend): Docker deploy, log ESP32 online, perintah ke device, Swagger
    - Dockerfile + docker-compose (backend + mongo), deploy nginx + Cloudflare Tunnel
    untuk capstone.irsad.site
    - Pesan WS bertipe (log, audio_test, hello) tidak lagi masuk processor ABR
    - Ring buffer log per device (1000 baris), GET /api/v1/logs dan SSE /api/v1/logs/stream
    - /api/v1/devices menambah field detail (status audio_test terakhir, last_seen)
    - POST /api/v1/command per device (404 jika tidak terhubung), /api/v1/broadcast
    benar-benar mengirim {"type":"command","cmd":...} (GET ?msg= dan POST)
    - Write WS diserialisasi per koneksi, ping/pong 30 detik buang koneksi mati
    - Halaman /logs (serial monitor web) dan S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
2026-10-22 feat: sinkronkan frontend dengan backend, halaman admin + dummy ABR
    Backend:
    - fix(analysis): deteksi gelombang I/III/V mulai dari onset stimulus
    (sebelumnya ikut membaca 10 ms pra-stimulus), abaikan average kosong
    - stimulus: GET /stim, POST /stim/start & /stim/stop, validasi stim/set
    - save sesi menyimpan ear/device/stim_db/note; hasil ABR berisi
    pre_stim_ms, stim_count, frame_count; health berisi mongo & uptime_s
    - device status berisi frames & last_frame_at
    - generator dummy ABR di server (/api/v1/dummy, dilindungi LOG_TOKEN)
    - openapi.yaml diperbarui
    Frontend:
    - semua halaman memakai data backend asli (µV, 16 kHz, sumbu relatif
    stimulus), data palsu dihapus, verdict Pass/Refer/I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
2026-10-22 feat(dummy): replay rekaman ABR .npz dari server + fix deteksi puncak
    - sumber dummy baru: replay rekaman abr/dummy/*.npz (di-resample ke 16 kHz
    lewat dsp/dummy_npz.py), diputar berulang sampai batas stimulus
    - GET /api/v1/dummy/sources: daftar rekaman + ground truth per level
    - docker-compose mount abr/dummy ke /app/dummy-data (DUMMY_DIR)
    - fix(analysis): gelombang I/III/V dicari sebagai puncak positif, bukan
    |nilai| terbesar yang sering jatuh ke lembah
    - admin: pilihan source (synthetic / rekaman per dB), tampilkan ground truth
    Claude-Session: https://claude.ai/code/session_012AK7DvMa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
2026-10-22 fix(audio-only): captive portal auto-buka di Samsung/Android
    - DHCP option 114 (RFC 8910) + DNS 192.168.4.1 diiklankan ke klien
    - scan WiFi sekali sebelum AP aktif (scan saat ada klien bikin HP lepas),
    /scan untuk scan ulang
    - probe OS (generate_204, gen_204, Apple, Windows, Firefox) didaftarkan
    eksplisit, httpd lru_purge untuk banyak socket dari HP
    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
2026-10-23 feat(frontend): revamp UI, tes dua telinga multi-level, logo NeuroSound
    - komponen bersama di ui.tsx (Button, Card, Badge, Segmented, Toggle, Stat, Row),
    font Inter + JetBrains Mono via next/font, label sentence case, palet tetap
    - sidebar bisa diciutkan (data-sidebar di <html>), logo PNG NeuroSound,
    status backend/device; topbar dengan ikon halaman dari lib/nav.ts
    - Start Scan: satu klik tes kiri lalu kanan di beberapa level dB (Settings),
    simpan otomatis per level, berhenti di ambang, panel per telinga dengan
    gelombang bertumpuk dan threshold; detail teknis di bagian tersembunyi
    - detail teknis dikurangi di dashboard, history, result, runtime checks
    - metadata: icon, apple-icon, Op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
2026-10-23 feat(audio-only): sensor baterai IO35, portal setema dashboard
    - battery.c: pembagi 220k/100k di IO35 (ADC1), kalibrasi ADC, kurva Li-ion,
    perintah bat, bat_mv/bat_pct ikut status audio_test ke backend
    - captive portal pakai palet NeuroSound terang/gelap, daftar WiFi dengan
    indikator sinyal, dedupe SSID, toggle lihat password
    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
2026-10-23 feat(abr): klasifikasi normal ya/tidak + replay dummy mulai dari sweep acak
    - analysis: field normal + reasons. Normal = Pass dan interpeak I-III,
    III-V, I-V di rentang dewasa normal (mean ± 2 SD, click 85 dB nHL)
    - frontend: tampilkan Normal Yes/No di admin dan results, rentang norma
    di kartu interpeak; detectWaves fallback pakai puncak positif
    - dummy: opsi random_start untuk rekaman, indeks sweep di start_sweep
    Claude-Session: https://claude.ai/code/session_012AK7DvMa4f8FQtSekDPTy6
2026-10-24 chore(audio-only): pembagi R2/R5 diganti 330 Ω (-36.6 dB)
    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
2026-10-26 feat: firmware esp dengan ADS1299, frame biner di backend, rapikan repo ke archive/
    - audio-only → esp/: driver ADS1299 (Board 1), stimulus ABR tersinkron, ads check, mode debug
    - backend: parse frame WebSocket biner (0xEE, 16 kSPS) + test
    - folder lama dipindah ke archive/, skematik final di schematic-fix/, model 3D di 3d-new/
    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
2026-10-27 feat(dummy): simpan rekaman dummy di MongoDB GridFS
    - POST /api/v1/dummy/upload (multipart, token): .npz ke GridFS bucket
    "dummy" + info di dummy_recordings, ground_truth.json ke dummy_meta
    - /dummy/sources dan replay memakai MongoDB; folder DUMMY_DIR jadi cadangan
    - dummy_npz.py: mode --info / --gt dan baca .npz dari stdin
    - nginx: client_max_body_size 256m untuk upload
    - admin: label sumber rekaman (MongoDB / folder)
    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
2026-10-29 feat: firmware esp-ads1256 (ADS1256 15 kSPS, paket v2), kalibrasi driver L/R
    - esp-ads1256/: ADS1256 + AD620 menggantikan ADS1299, satu kanal per sesi
    (ipsilateral dengan telinga yang dibunyikan), paket biner v2
    - filter glitch DRDY di ISR + debounce polling, bus SPI ditahan saat streaming
    - kalibrasi driver: kiri -5.5 dB, perintah "cal L|R <dB>"
    - backend Fs 15000 + paket v2, frontend scan kanan lalu kiri
    - sketch uji ADS1256 (live, pins, scan) dan dokumen setup
    Claude-Session: https://claude.ai/code/session_01Y2wBdzkmht2eYSSFG8PrTW
2026-10-30 feat: dummy bisa dipercepat dari admin, DSP worker persisten
    - dsp_worker.py --serve + Runner persisten: numpy/scipy di-import sekali
    (2,5 → ~500 trial/s); kembali ke proses per trial kalau worker gagal
    - dummy: opsi speed 1..20× real-time, POST /api/v1/dummy/speed saat berjalan,
    slider di halaman admin
    - frame ESP diabaikan selama dummy berjalan (tidak tercampur)
    - esp-ads1256: ADS_SKIP_ID_CHECK untuk uji koneksi, ads check memulihkan streaming
    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
2026-10-31 fix(backend): artifact rejection, r split-half, verdict dari keterulangan
    Validasi dengan rekaman dummy berkunci jawaban menunjukkan pemrosesan sinyal benar
    tapi keputusan salah (3/8 level benar):
    - pearson_r dibanding rata-rata 1 trial sebelumnya, selalu ≈1 → "Konvergen" palsu
    - SNR RMS 0-50 ms vs 10 ms pra-stimulus tidak membedakan respons dari noise
    - jendela III tetap 3.5-4.5 ms meleset saat latensi bergeser dengan level
    - lonjakan salah-baca ADC masuk ke rata-rata
    Perubahan:
    - dsp_worker: epoch dibuang bila sampel terfilter > 8× noise robust (min 25 µV)
    - processor: sub-rata-rata ganjil/genap; r = korelasi keduanya di 1-10 ms,
    SNR ± average; status Konvergen = ≥500 trial dan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
2026-11-05 feat(esp): firmware ADS1256 yang terakhir di-flash
    - dc_ok menilai offset DC selisih (bukan per pin)
    - fail-safe stimulus dari backend: mati bila WS putus > 3 s atau > 10 menit
    - net/sdkconfig: buffer TCP, mbedTLS dynamic buffer, tcpip di core 0, MSS 1200
    - kredensial WiFi dipindah ke src/wifi_default.h (gitignored), contoh disertakan
    Claude-Session: https://claude.ai/code/session_01Y2wBdyvP81y9fNzuLDniid
2026-11-05 fix: cal tersimpan di NVS, auth endpoint tulis, nama file unik, health DSP, perbaikan FE
    - firmware: "cal L/R x" disimpan di NVS (bertahan setelah restart), "cal reset" kembali ke bawaan
    - backend: stim/set/start/stop, reset, abr/save butuh LOG_TOKEN; nama file sesi berbasis milidetik dan unik;
    health "degraded" + dsp_error bila DSP worker hilang; sesi menyimpan stim_type
    - frontend: kirim token untuk endpoint tertulis, spesifikasi hardware benar (x20, 2.5 V, 0.0298 uV/LSB),
    baris DSP worker di Device, label stimulus dari sesi, input Trials tidak dipotong tiap ketukan
    Claude-Session: https://claude.ai/code/session_01Y2wBdyvP81y9f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
